bnparks-KSU/L3CertificationRocket/Documentation/Photos/Physical/AllParts-Airframe.jpg

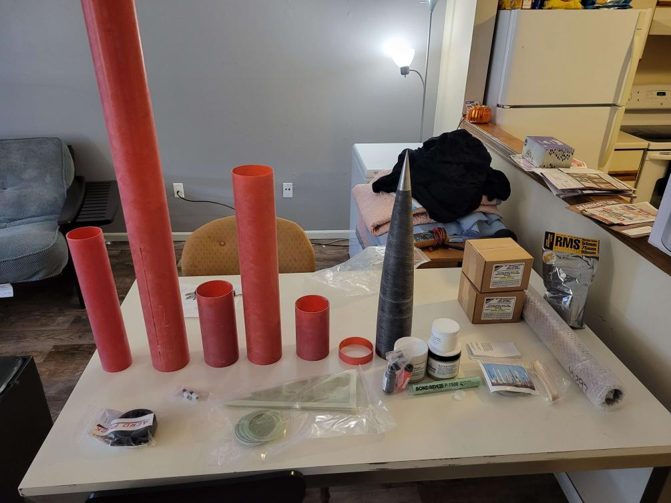
Documentation/Photos/Physical/AllParts-Airframe.jpg
