bnparks-KSU/L3CertificationRocket/Documentation/Photos/Physical/EBayAssembled.jpg

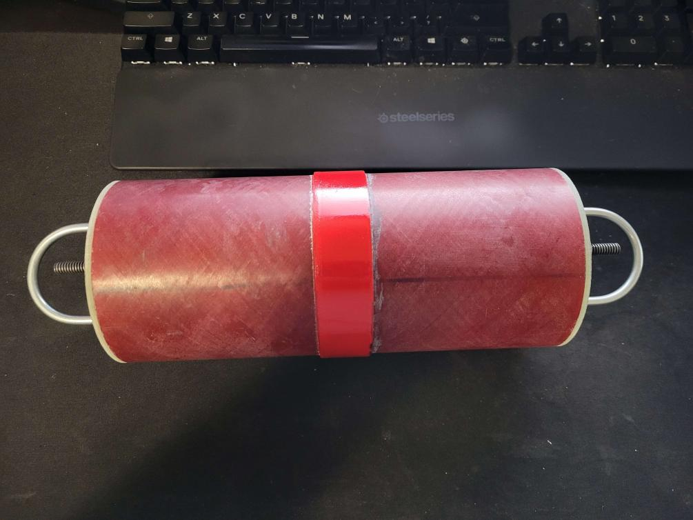
Documentation/Photos/Physical/EBayAssembled.jpg
