bnparks-KSU/L3CertificationRocket/Documentation/Photos/Physical/Bath.jpg

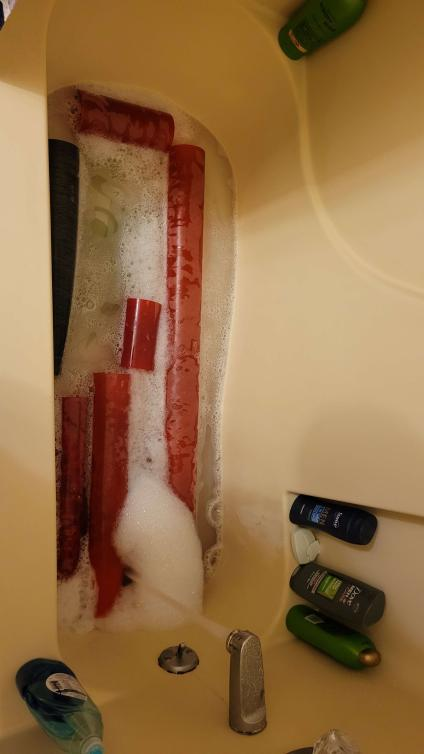
Documentation/Photos/Physical/Bath.jpg
