bnparks-KSU/L3CertificationRocket/Documentation/Photos/Physical/Box.jpg

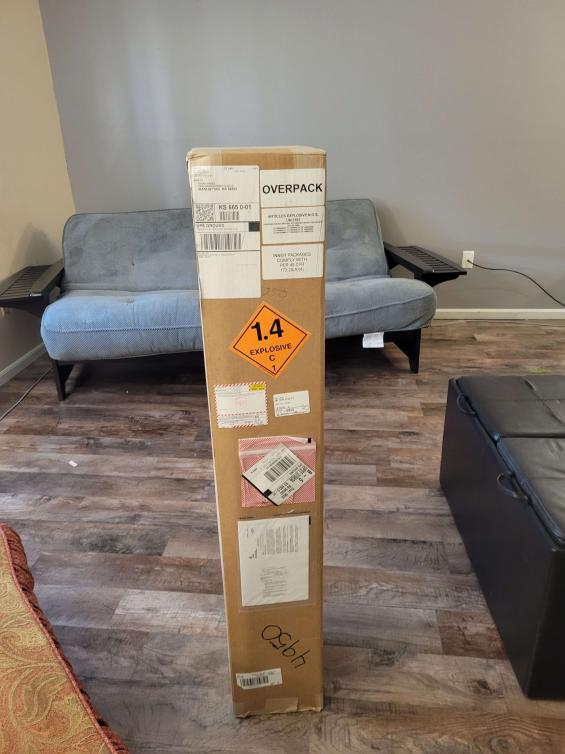
Documentation/Photos/Physical/Box.jpg
