bnparks-KSU/L3CertificationRocket/Documentation/Photos/Physical/BulkheadCNC.jpg

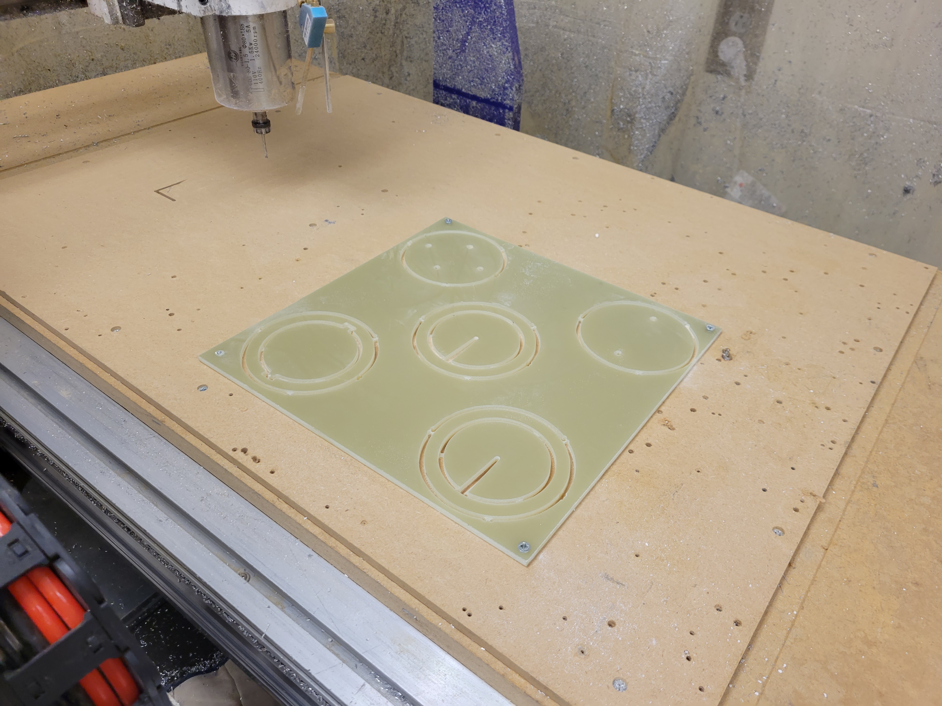
Documentation/Photos/Physical/BulkheadCNC.jpg
