bnparks-KSU/L3CertificationRocket/Documentation/Photos/Physical/ClampedBody.jpg

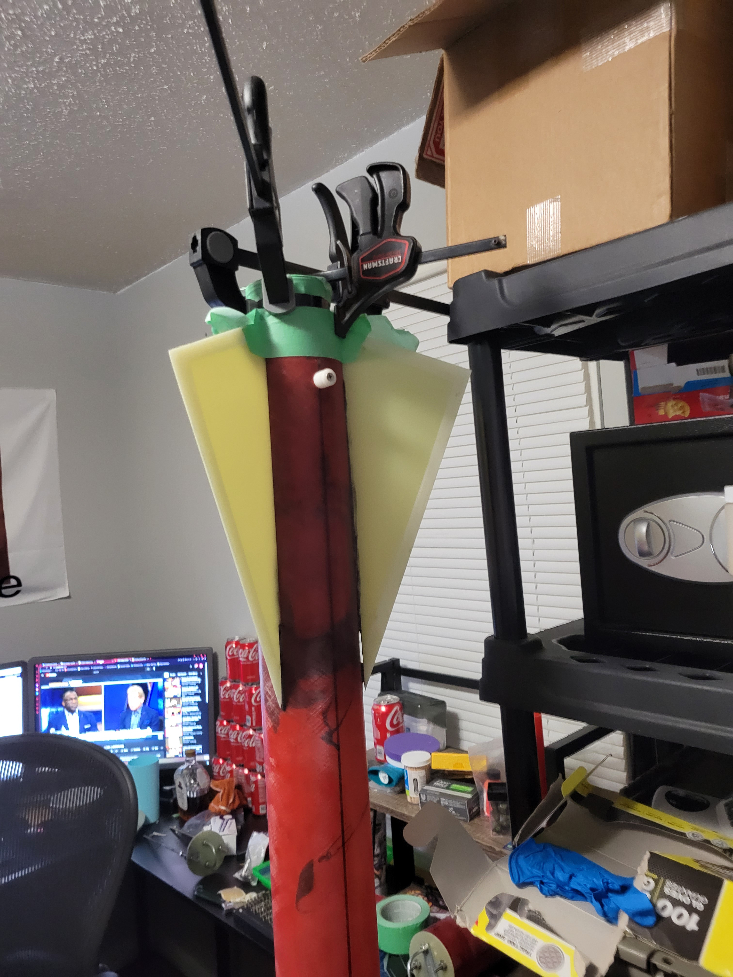
Documentation/Photos/Physical/ClampedBody.jpg
