bnparks-KSU/L3CertificationRocket/Documentation/Photos/Physical/DrogueRecovLayout.jpg

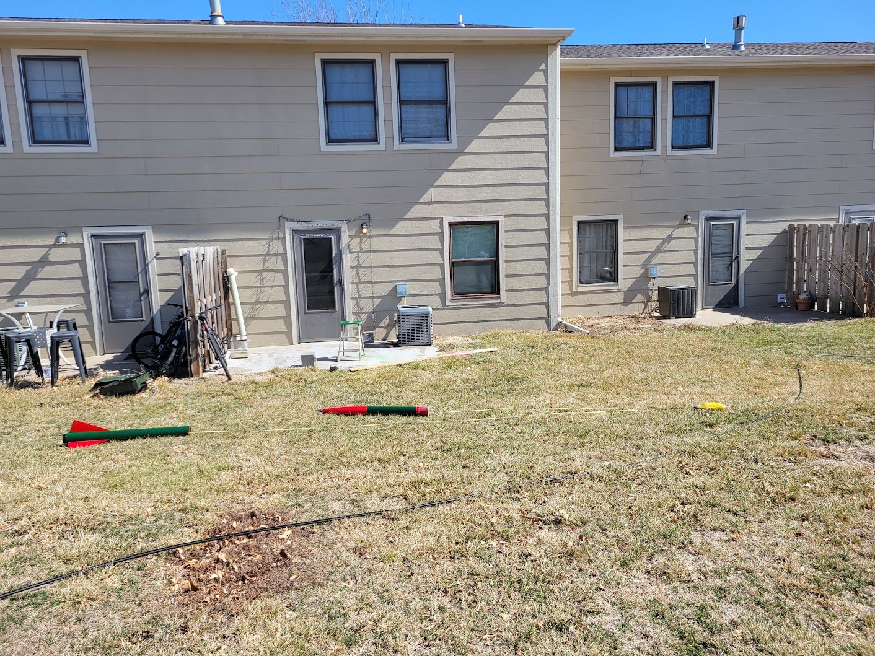
Documentation/Photos/Physical/DrogueRecovLayout.jpg
