bnparks-KSU/L3CertificationRocket/Documentation/Photos/Physical/DryFit-NoFin.jpg

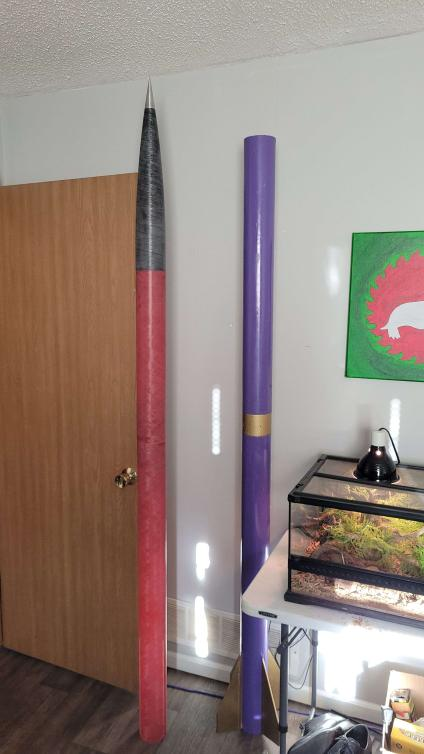
Documentation/Photos/Physical/DryFit-NoFin.jpg
