bnparks-KSU/L3CertificationRocket/Documentation/Photos/Physical/EBayBack.jpg

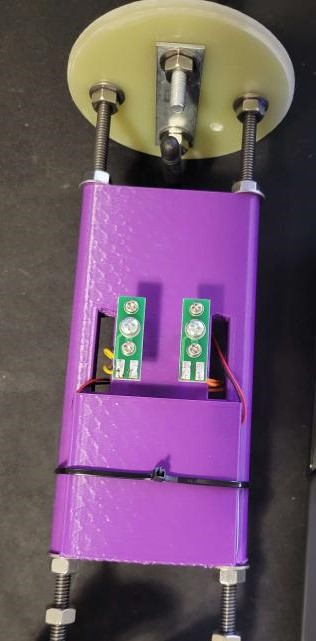
Documentation/Photos/Physical/EBayBack.jpg
