bnparks-KSU/L3CertificationRocket/Documentation/Photos/Physical/EBayFront.jpg

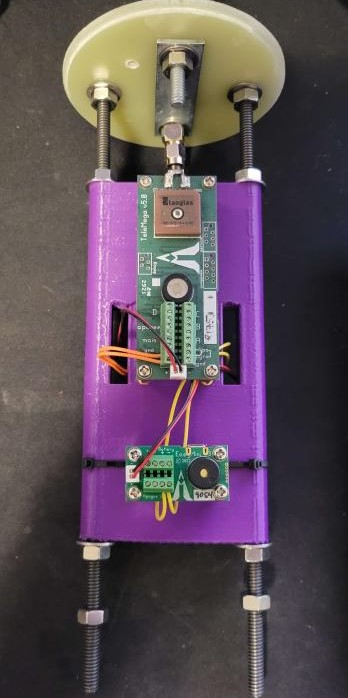
Documentation/Photos/Physical/EBayFront.jpg
