bnparks-KSU/L3CertificationRocket/Documentation/Photos/Physical/ExternalRocketpoxy.jpg

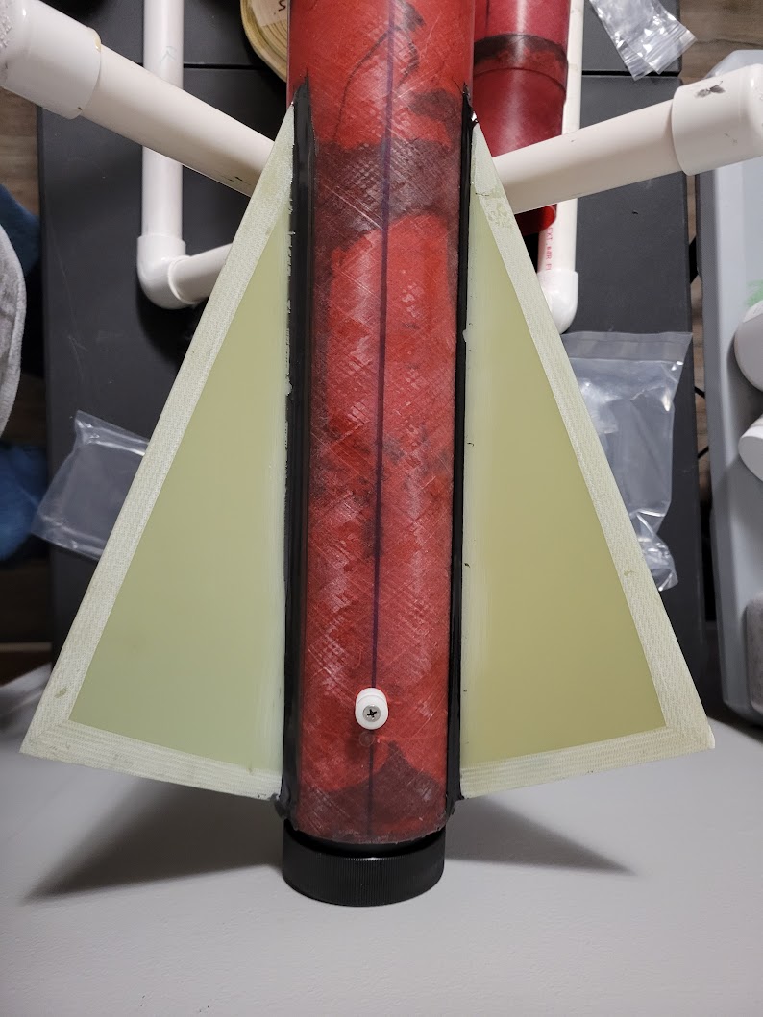
Documentation/Photos/Physical/ExternalRocketpoxy.jpg
