bnparks-KSU/L3CertificationRocket/Documentation/Photos/Physical/FinCan-Rocketpoxying.jpg

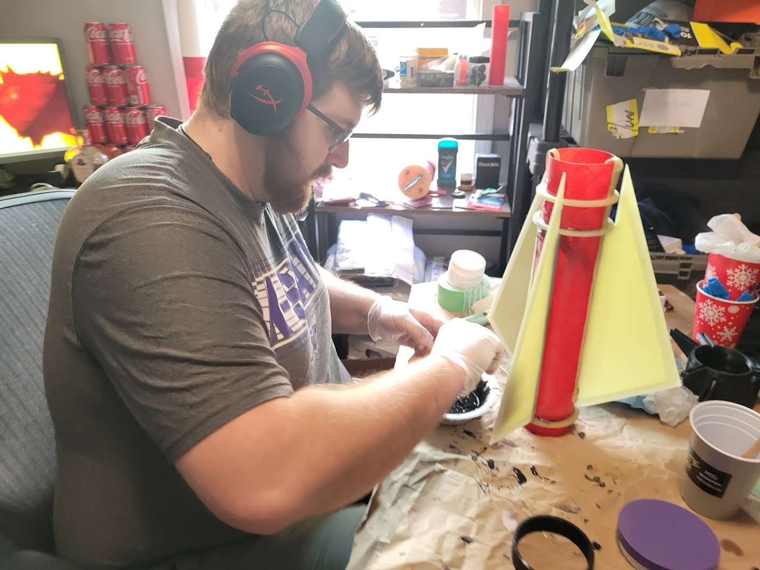
Documentation/Photos/Physical/FinCan-Rocketpoxying.jpg
