bnparks-KSU/L3CertificationRocket/Documentation/Photos/Physical/FinCanFinal.jpg

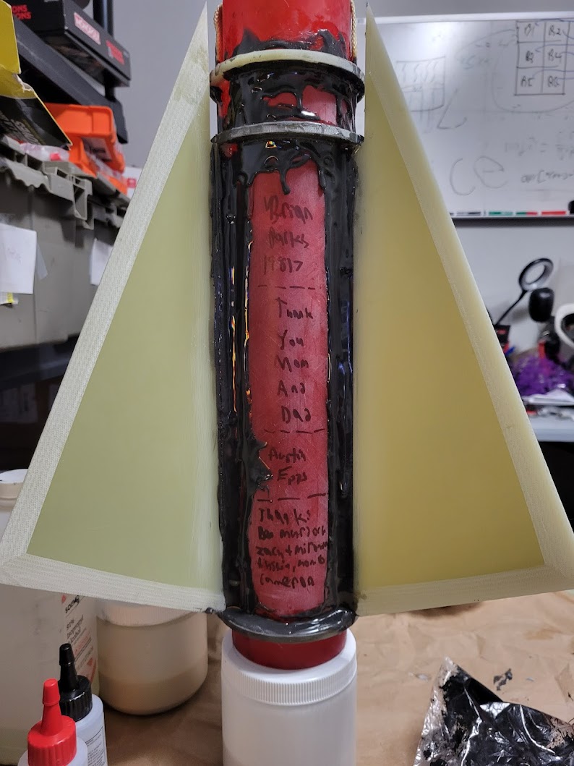
Documentation/Photos/Physical/FinCanFinal.jpg
