bnparks-KSU/L3CertificationRocket/Documentation/Photos/Physical/FinFilletPainting.jpg

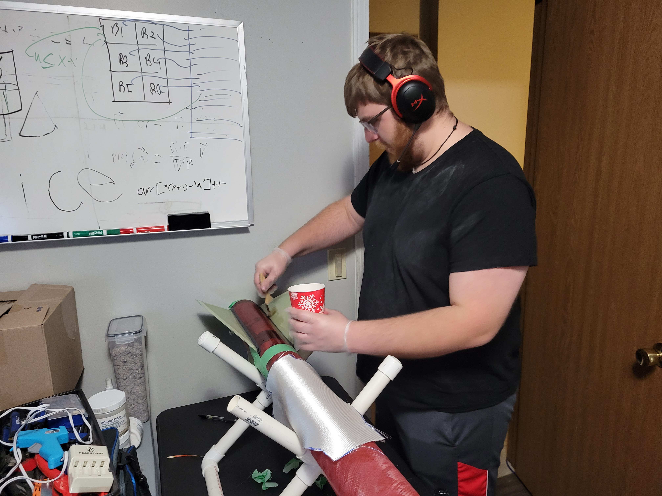
Documentation/Photos/Physical/FinFilletPainting.jpg
