bnparks-KSU/L3CertificationRocket/Documentation/Photos/Physical/FinFilletPeel.jpg

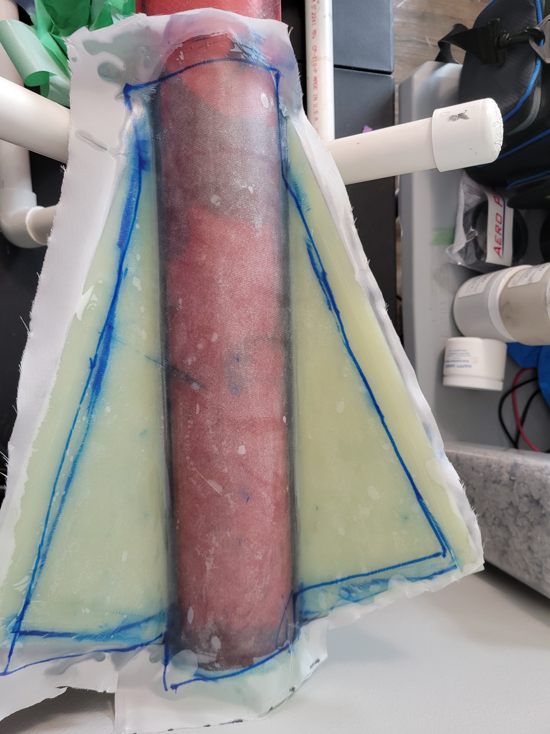
Documentation/Photos/Physical/FinFilletPeel.jpg
