bnparks-KSU/L3CertificationRocket/Documentation/Photos/Physical/FinSlotFilled.jpg

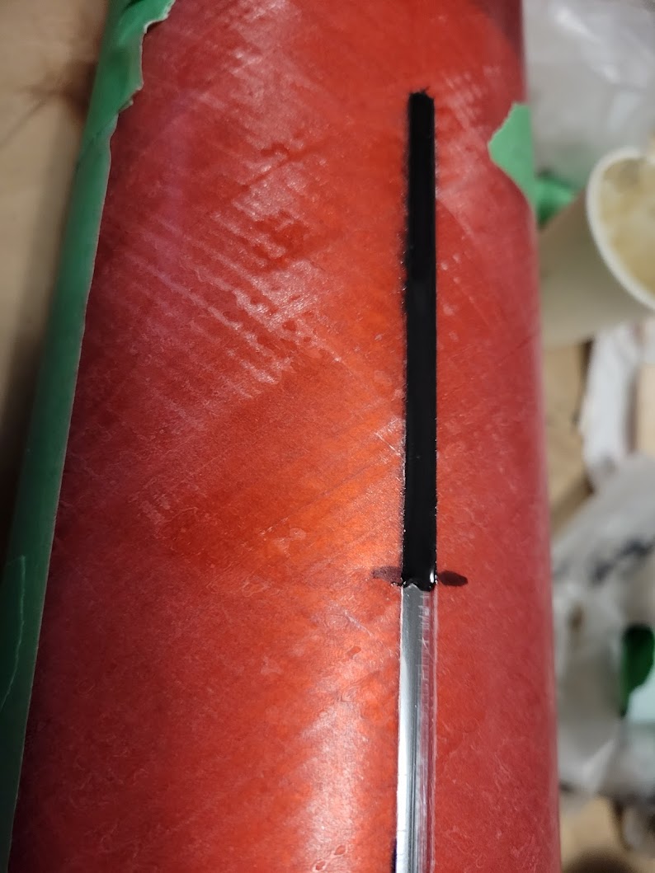
Documentation/Photos/Physical/FinSlotFilled.jpg
