bnparks-KSU/L3CertificationRocket/Documentation/Photos/Physical/FinSlotFilling.jpg

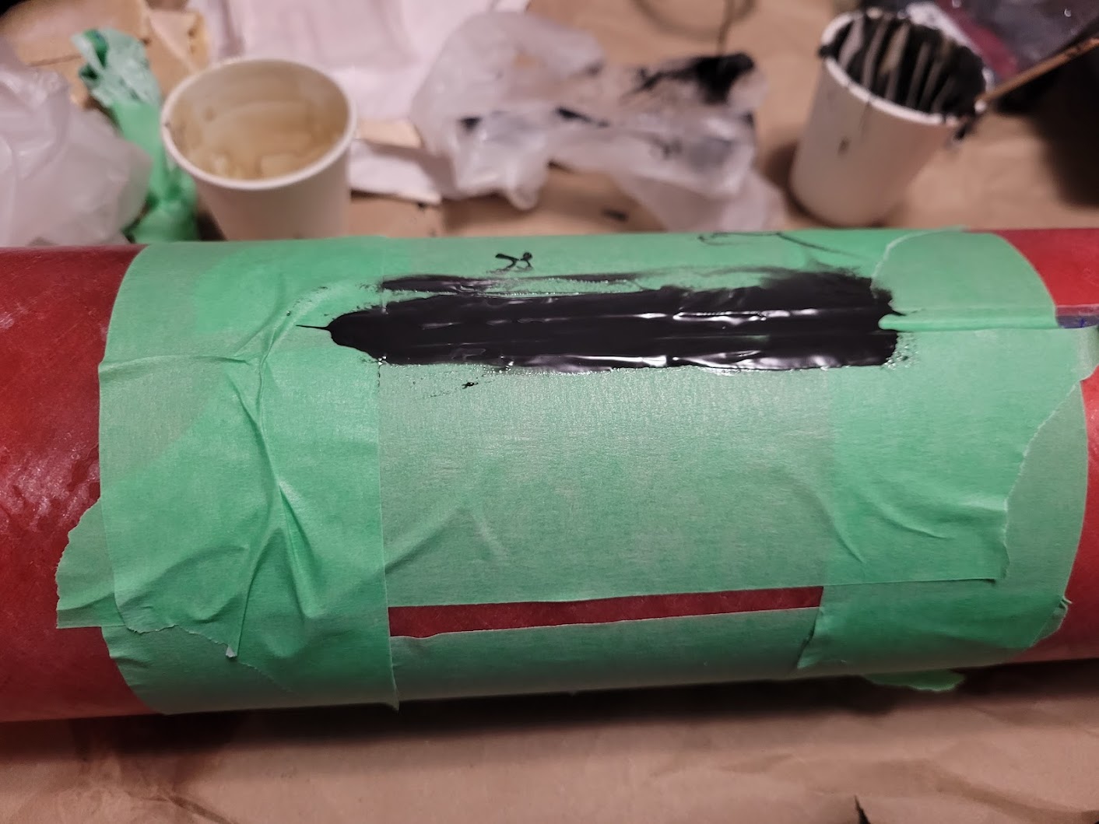
Documentation/Photos/Physical/FinSlotFilling.jpg
