bnparks-KSU/L3CertificationRocket/Documentation/Photos/Physical/FinSlotsTooBig.jpg

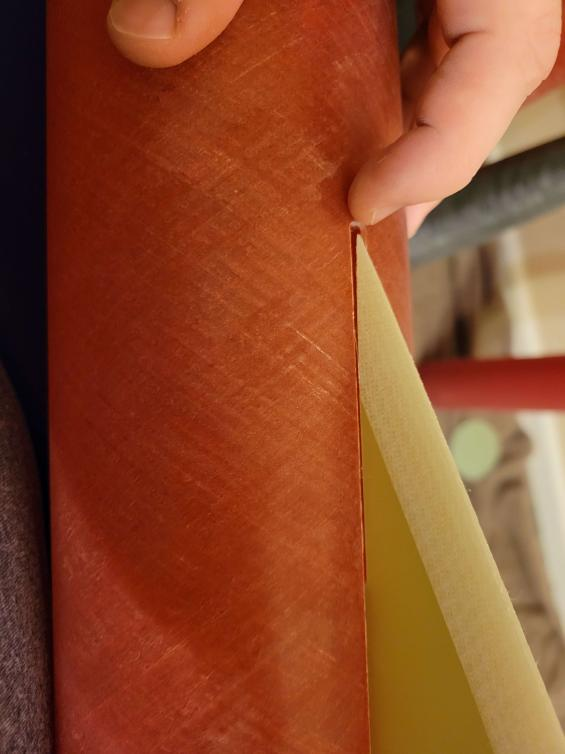
Documentation/Photos/Physical/FinSlotsTooBig.jpg
