bnparks-KSU/L3CertificationRocket/Documentation/Photos/Physical/FullRecovLayout.jpg

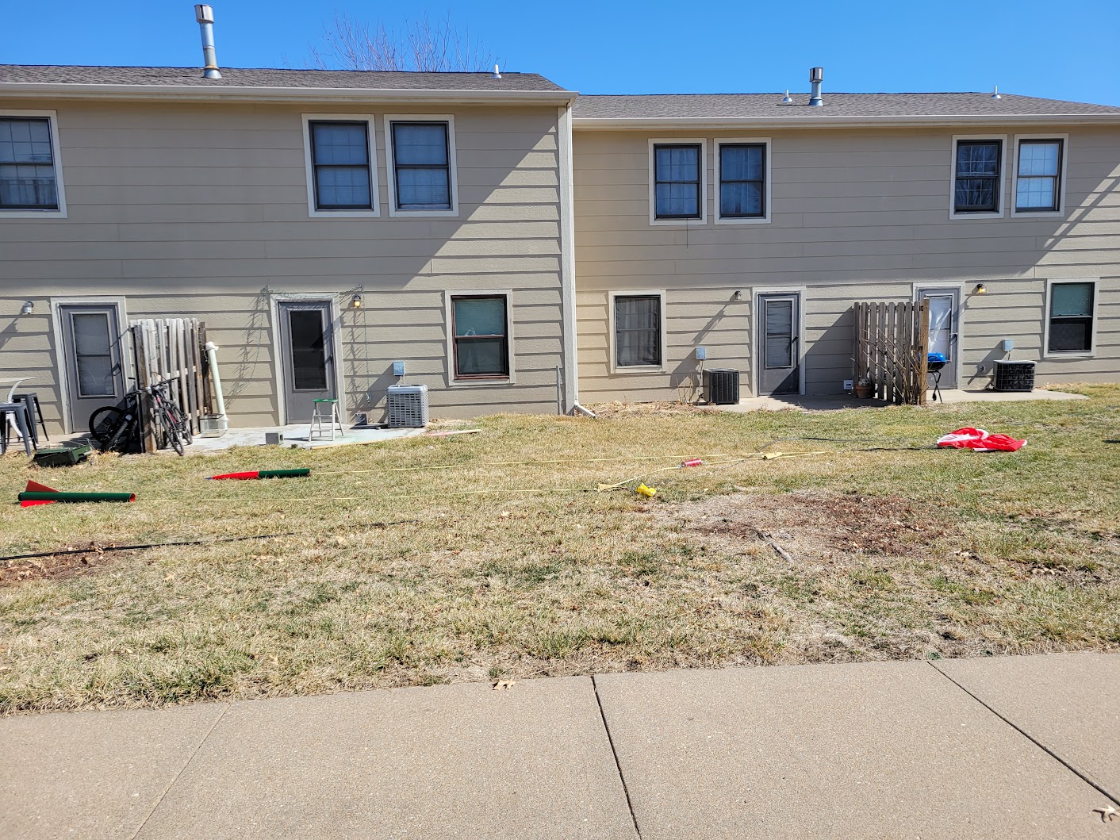
Documentation/Photos/Physical/FullRecovLayout.jpg
