bnparks-KSU/L3CertificationRocket/Documentation/Photos/Physical/LBT-Painted.jpg

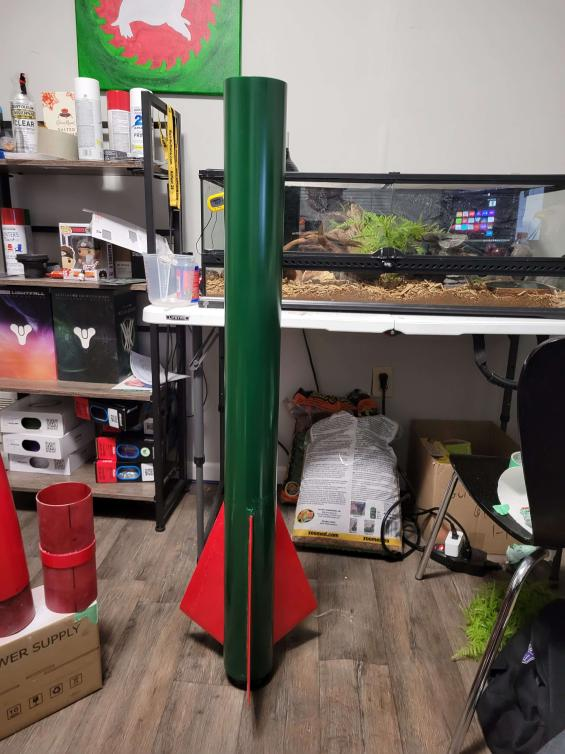
Documentation/Photos/Physical/LBT-Painted.jpg
