bnparks-KSU/L3CertificationRocket/Documentation/Photos/Physical/NC-SB-Painted.jpg

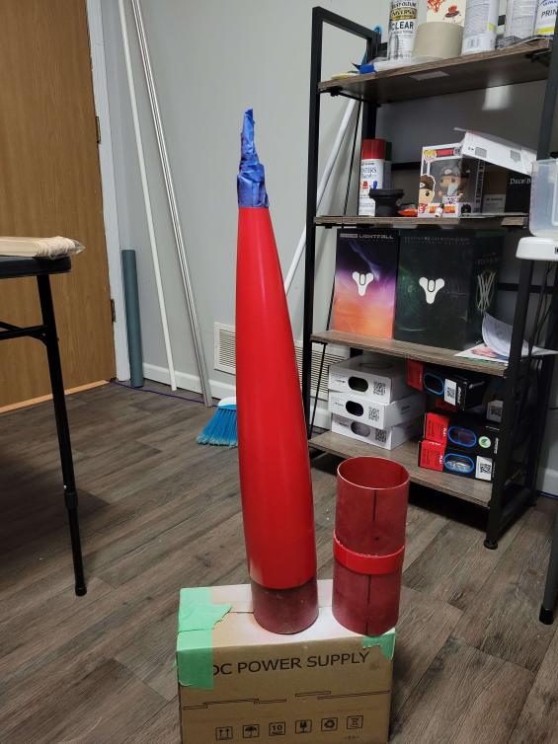
Documentation/Photos/Physical/NC-SB-Painted.jpg
