bnparks-KSU/L3CertificationRocket/Documentation/Photos/Physical/NoseconeCoupler-DryFit-Aft.jpg

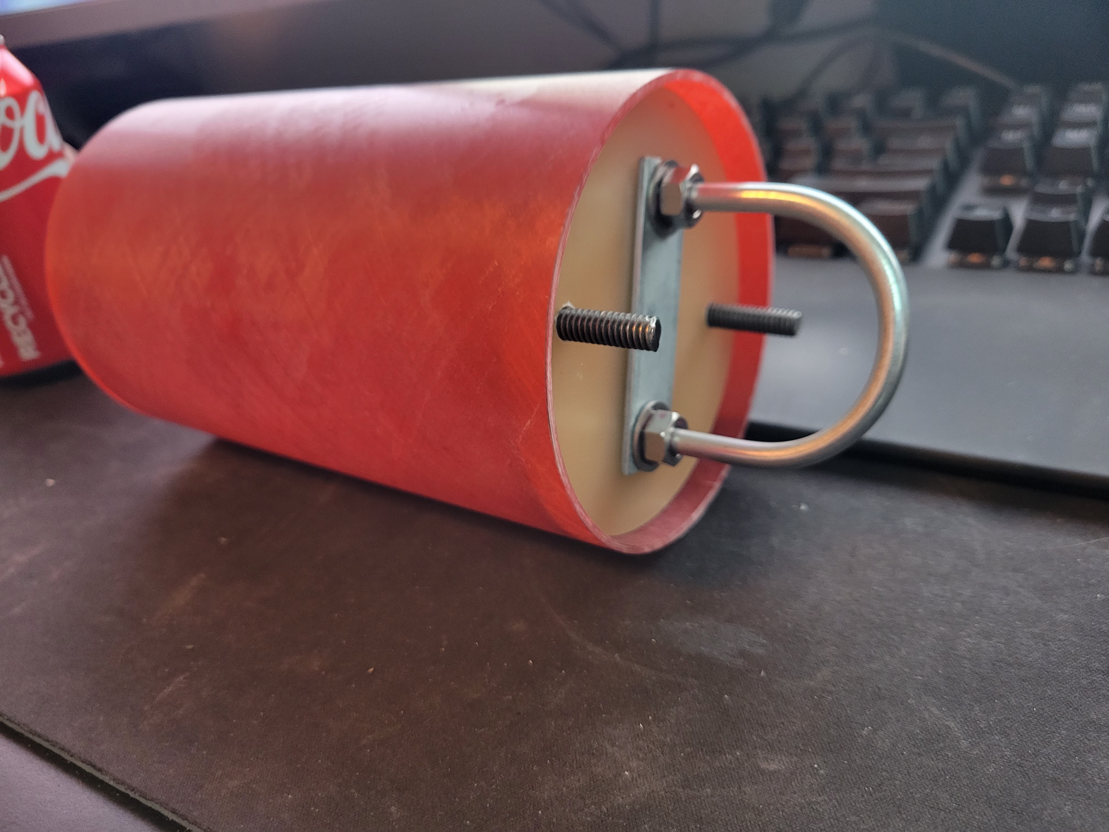
Documentation/Photos/Physical/NoseconeCoupler-DryFit-Aft.jpg
