bnparks-KSU/L3CertificationRocket/Documentation/Photos/Physical/NoseconeCoupler-DryFit-Forward.jpg

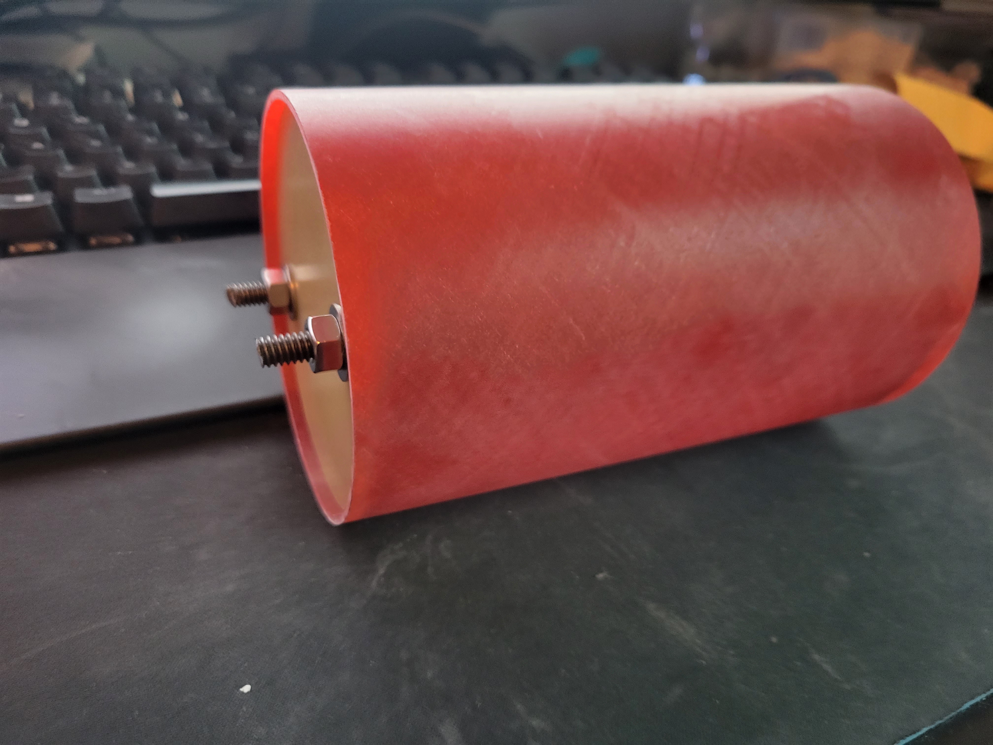
Documentation/Photos/Physical/NoseconeCoupler-DryFit-Forward.jpg
