bnparks-KSU/L3CertificationRocket/Documentation/Photos/Physical/NoseconeCoupler-Epoxy1.jpg

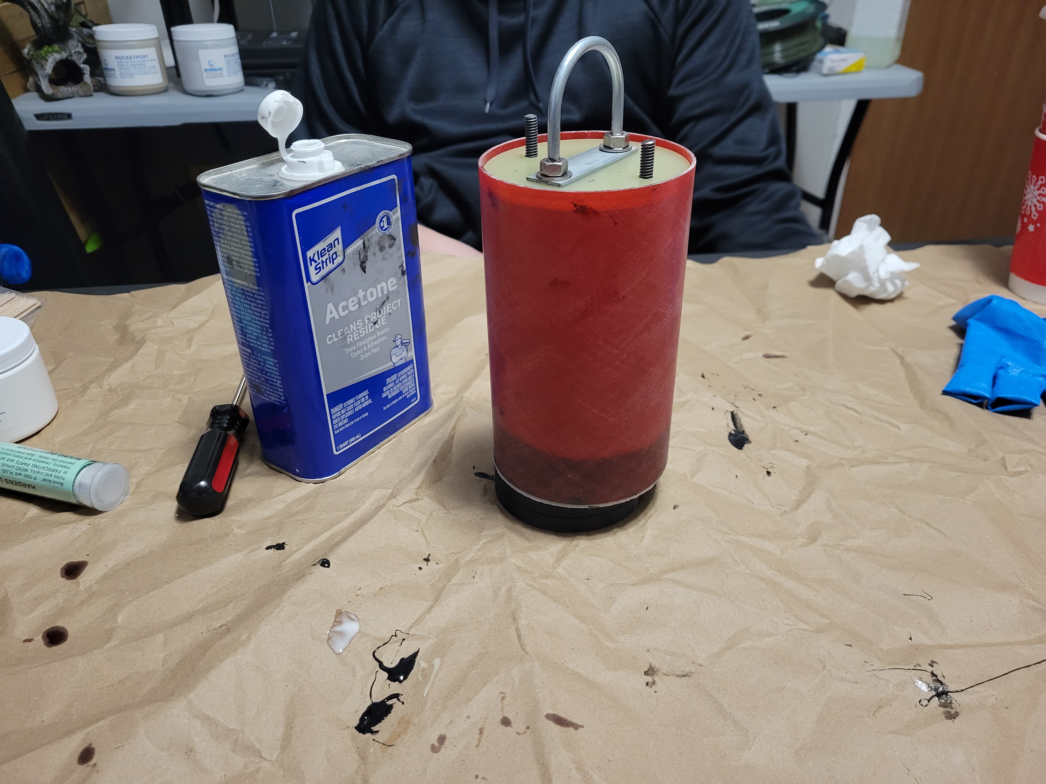
Documentation/Photos/Physical/NoseconeCoupler-Epoxy1.jpg
