bnparks-KSU/L3CertificationRocket/Documentation/Photos/Physical/NoseconeCoupler-Inserted.jpg

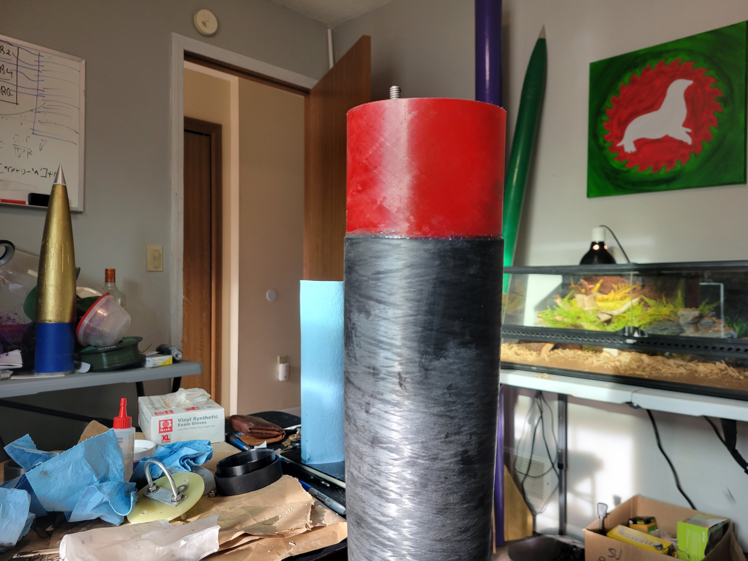
Documentation/Photos/Physical/NoseconeCoupler-Inserted.jpg
