bnparks-KSU/L3CertificationRocket/Documentation/Photos/Physical/PrimerCoats.jpg

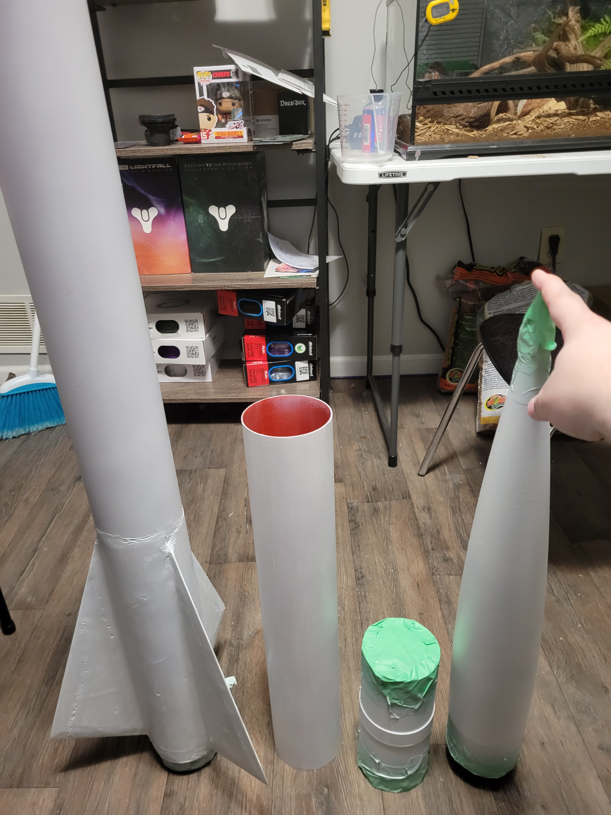
Documentation/Photos/Physical/PrimerCoats.jpg
