bnparks-KSU/L3CertificationRocket/Documentation/Photos/Physical/Switchband-Mounted.jpg

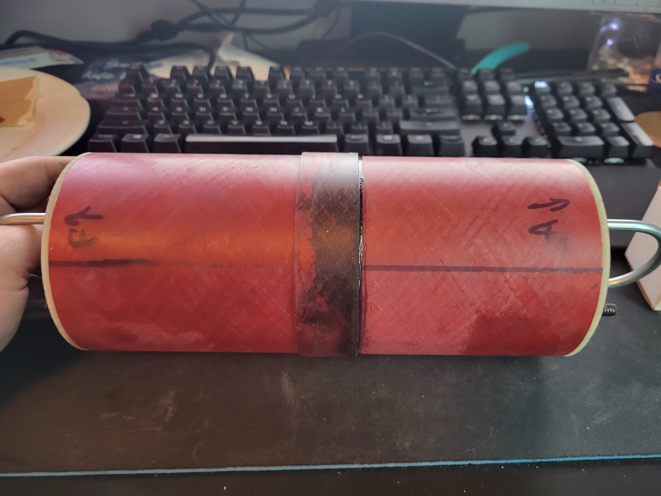
Documentation/Photos/Physical/Switchband-Mounted.jpg
