bnparks-KSU/L3CertificationRocket/Documentation/Photos/Physical/UBT-Painted.jpg

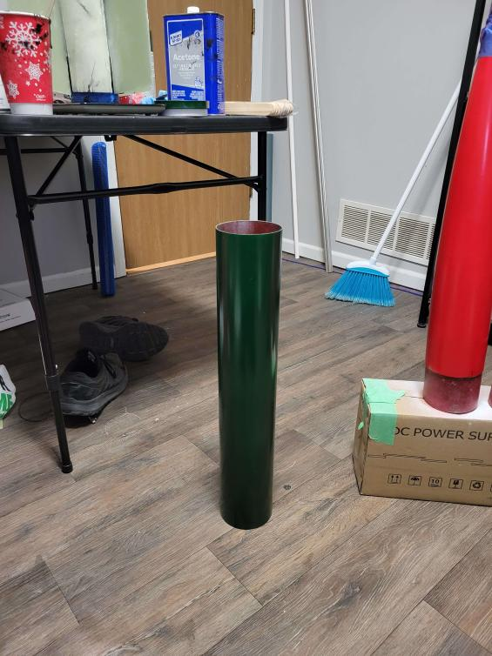
Documentation/Photos/Physical/UBT-Painted.jpg
