bnparks-KSU/L3CertificationRocket/Documentation/Photos/Solidworks/CenteringRingWithCutCAM.PNG

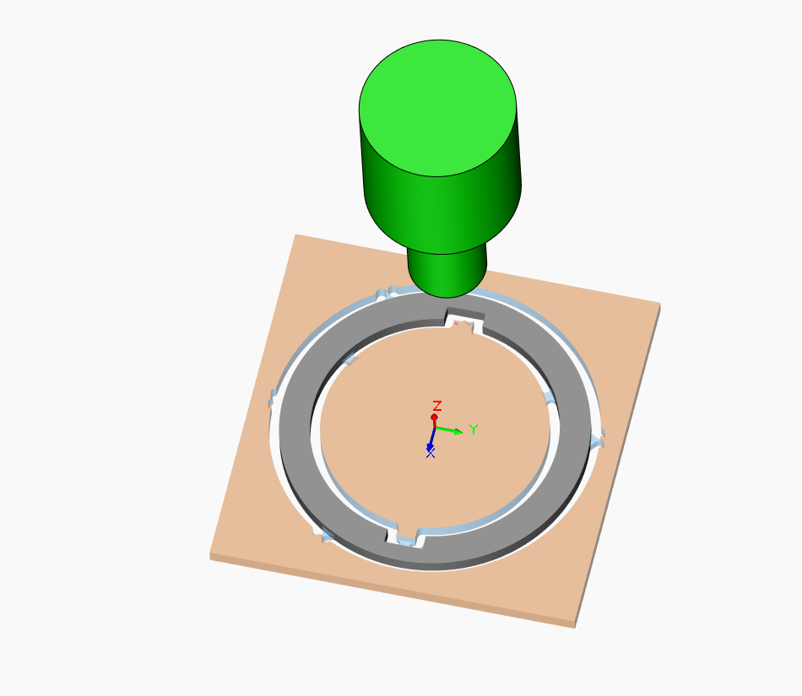
Documentation/Photos/Solidworks/CenteringRingWithCutCAM.PNG
