bnparks-KSU/L3CertificationRocket/Documentation/Photos/Solidworks/EBay.PNG

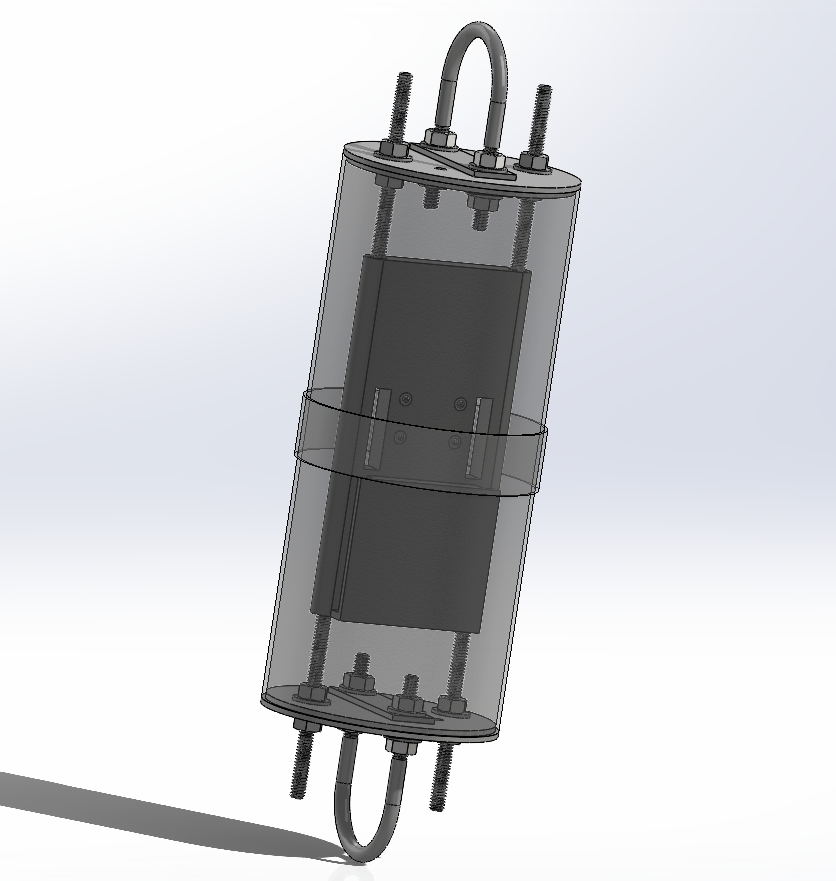
Documentation/Photos/Solidworks/EBay.PNG
