bnparks-KSU/L3CertificationRocket/Documentation/Photos/Solidworks/FinJig.PNG

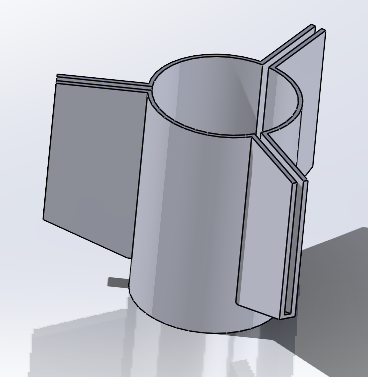
Documentation/Photos/Solidworks/FinJig.PNG
