bnparks-KSU/L3CertificationRocket/Documentation/Photos/Solidworks/L3-Model.PNG

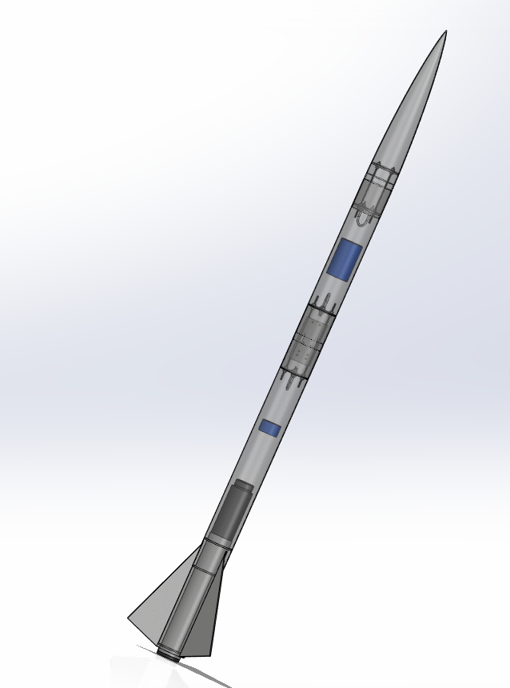
Documentation/Photos/Solidworks/L3-Model.PNG
