bnparks-KSU/L3CertificationRocket/Documentation/Photos/Solidworks/LaunchProfile.PNG

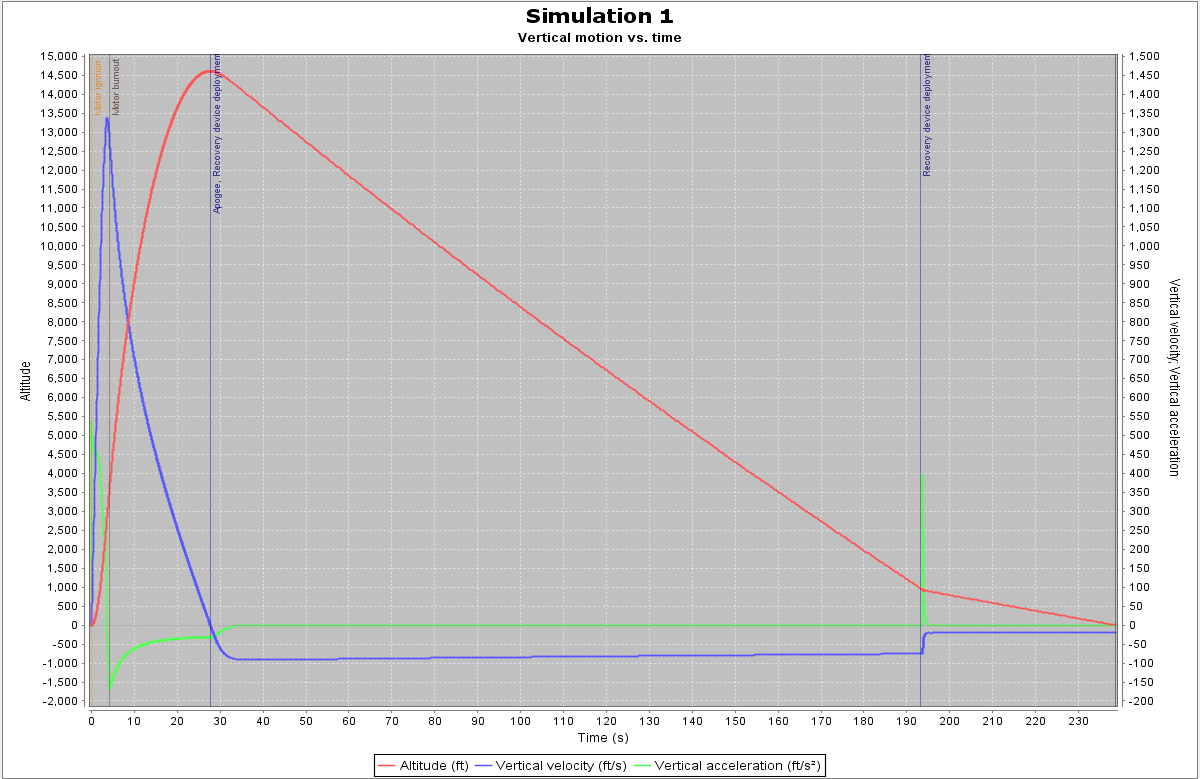
Documentation/Photos/Solidworks/LaunchProfile.PNG
