bnparks-KSU/L3CertificationRocket/Documentation/Photos/Solidworks/Nosecone.PNG

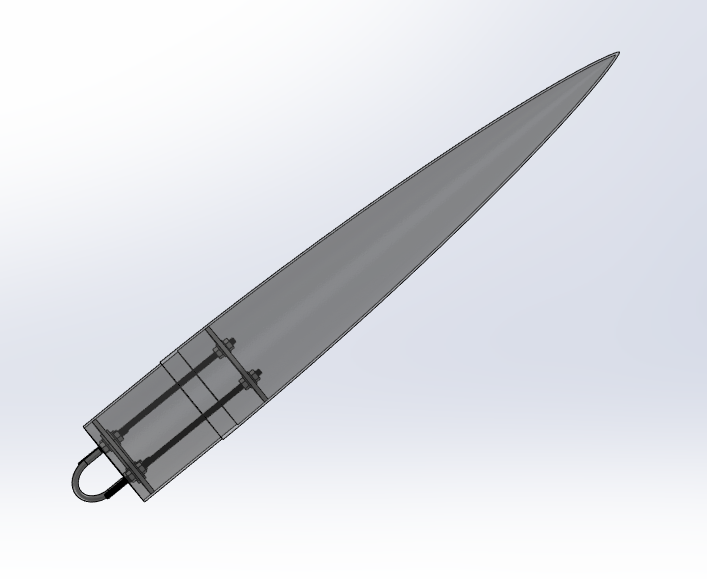
Documentation/Photos/Solidworks/Nosecone.PNG
