bnparks-KSU/L3CertificationRocket/Documentation/Photos/Solidworks/OpenRocket.PNG

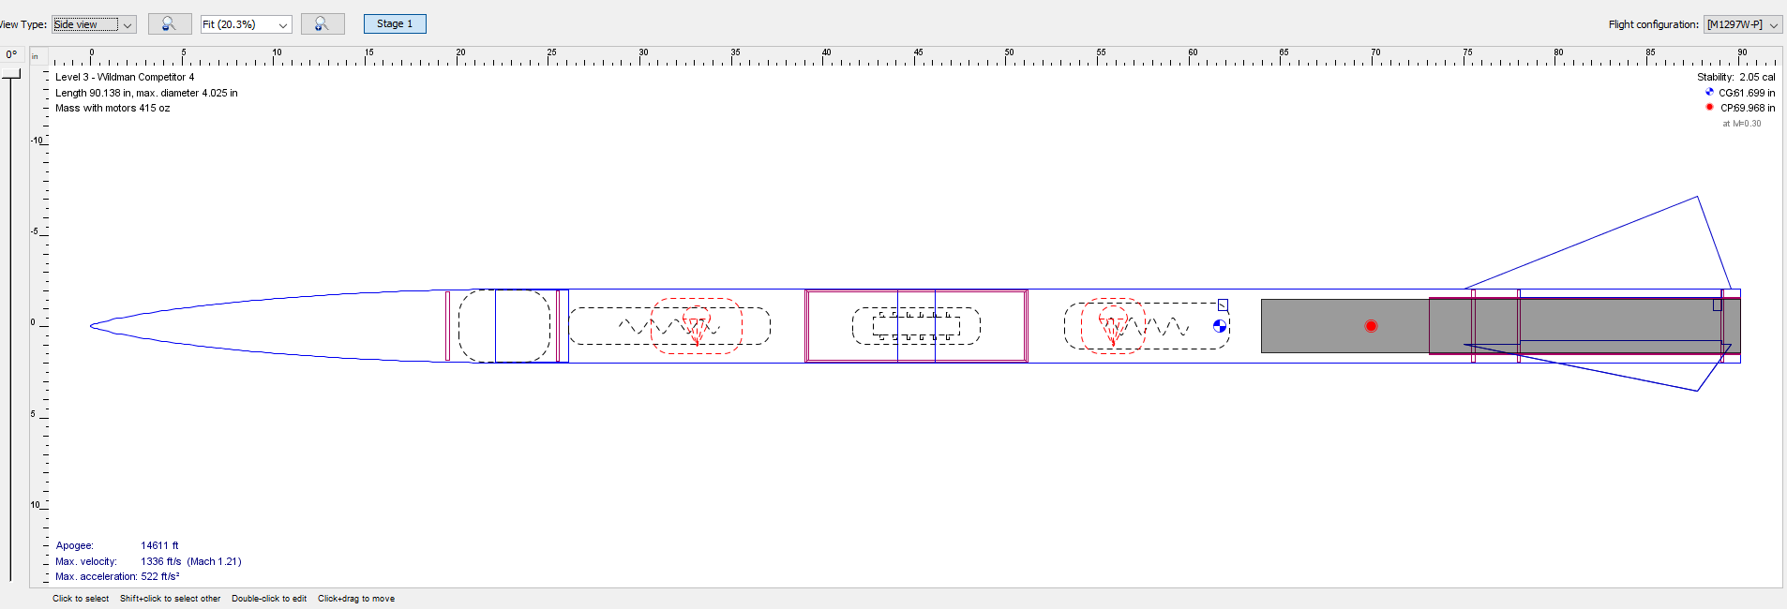
Documentation/Photos/Solidworks/OpenRocket.PNG
