bnparks-KSU/L3CertificationRocket/Documentation/Photos/Solidworks/PreFlightDataCapture.PNG

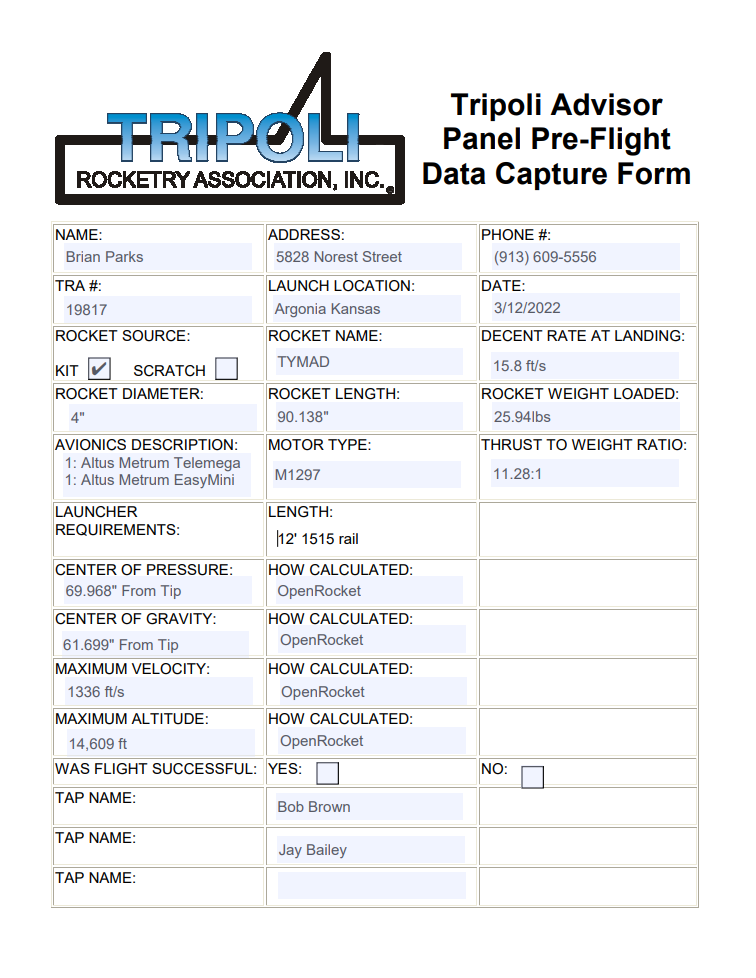
Documentation/Photos/Solidworks/PreFlightDataCapture.PNG
