bnparks-KSU/L3CertificationRocket/Documentation/Photos/Solidworks/Shoulder.PNG

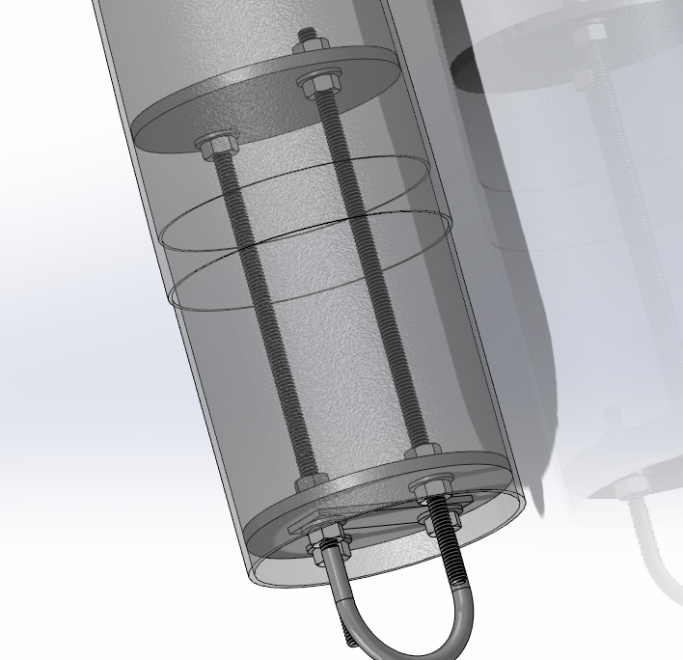
Documentation/Photos/Solidworks/Shoulder.PNG
