bnparks-KSU/L3CertificationRocket/Documentation/L3BOM.xlsx

Sheet: Summary
Category | Cost Total | Cost Remaining
Airframe | $400.97 | $0.00
Electronics | $507.00 | $0.00
Recovery | $228.05 | $134.05
Incidentals | $312.93 | $0.00
Total | $1448.95 | $134.05

Sheet: Airframe Materials
Item | Amount / Each | QTY | Total Cost | Purchased | Current Spent | Link:
Kit | $287.06 | 1.00 | $287.06 | 1 | $287.06 | https://wildmanrocketry.com/products/competitor-4 | Summary
Rail Guides | $9.00 | 1 | $9.00 | 1 | $9.00 | https://wildmanrocketry.com/products/2052-lg-rail-guides | Total Cost: | $400.97
Motor Retainer | $40.80 | 1 | $40.80 | 1 | $40.80 | https://wildmanrocketry.com/products/ra75p | Funding Needed: | $0.00
Rocketpoxy | $35.40 | 1 | $35.40 | 1 | $35.40 | https://wildmanrocketry.com/products/rocketpoxy-2-pint-kit
Extra G10 | $28.71 | 1 | $28.71 | 1 | $28.71 | https://wildmanrocketry.com/products/g10-3-16?_pos=1&_sid=27c007fa2&_ss=r
 |  |  | $0.00 | 1 | $0.00
 |  |  | $0.00 | 1 | $0.00
 |  |  | $0.00 | 1 | $0.00
 |  |  | $0.00 | 1 | $0.00
 |  |  | $0.00 | 1 | $0.00

Sheet: Electronics
Item | Amount / Each | QTY | Total Cost | Purchased | Current Spent | Link:
Telemega | $400.00 | 1 | $400.00 | 1 | $400.00 | https://csrocketry.com/electronics/altus-metrum/telemega.html | Summary
EasyMini | $80.00 | 1 | $80.00 | 1 | $80.00 | https://csrocketry.com/electronics/altus-metrum/easy-mini.html | Total Cost: | $507.00
850 mAh battery | $10.00 | 2 | $20.00 | 1 | $20.00 | https://csrocketry.com/electronics/altus-metrum/850-mah-battery.html | Funding Needed: | $0.00
Screw Switch | $3.50 | 2 | $7.00 | 1 | $7.00 | https://csrocketry.com/electronics/missleworks/6-32-screw-switch.html

Sheet: Recovery Hardware
Item | Amount / Each | QTY | Total Cost | Purchased | Current Spent | Link:
2ft Drogue | $33.50 | 1 | $33.50 | 1 | $33.50 | https://the-rocketman.com/chutes-html/ | Summary
6ft Main | $60.50 | 1 | $60.50 | 1 | $60.50 | https://the-rocketman.com/chutes-html/ | Total Cost: | $228.05
12" Flame Shield | $20.50 | 2 | $41.00 |  | $0.00 | https://the-rocketman.com/flame-shields/ | Funding Needed: | $134.05
Quick Links | $3.00 | 6 | $18.00 |  | $0.00 | Menards
Harness Set | $75.05 | 1 | $75.05 |  | $0.00 | https://wildmanrocketry.com/products/4-inch-harness?_pos=1&_sid=ddc1272e9&_ss=r

Sheet: Incidentals
Item | Amount / Each | QTY | Total Cost | Purchased | Current Spent | Link:
Casing | $0.00 | 1 | $0.00 |  | $0.00 | Borrowed from Team | Summary
M1297 | $256.35 | 1 | $256.35 | 1 | $256.35 | https://wildmanrocketry.com/products/m1297w | Total Cost: | $312.93
Threaded Rod (98957A801) | $3.06 | 2 | $6.12 | 1 | $6.12 | McMaster | Funding Needed: | $0.00
Ubolt (3043T618) | $5.28 | 1 | $5.28 | 1 | $5.28 | McMaster
Ubolt Plate (8875T929) | $1.91 | 2 | $3.82 | 1 | $3.82 | McMaster
Washers (92141A029) | $5.50 | 1 | $5.50 | 1 | $5.50 | McMaster
Nuts (91845A029) | $6.09 | 1 | $6.09 | 1 | $6.09 | McMaster
Heat Inserts (94180A331) | $16.81 | 1 | $16.81 | 1 | $16.81 | McMaster
Standoff Kit | $12.96 | 1 | $12.96 | 1 | $12.96 | https://www.amazon.com/Csdtylh-Male-Female-Standoff-Stainless-Assortment/dp/B06Y5TJXY1
