bnparks-KSU/L3CertificationRocket/Documentation/L3DCC.xlsx

Sheet: Data Input
Compiled Rocket Design Safety Checks Assembled by Ben Murdock, Brian Parks |  |  |  |  |  |  |  |  | Measurement System
 |  |  |  |  |  |  |  |  | Imperial
Launch Site Parameters |  |  | Vehicle Parameters |  |  | Flight Parameters
Parameter | Value | Unit | Parameter | Value | Unit | Parameter | Value | Unit
Ground Level Altitude | 1249 | ft | Outer Diameter | 4.025 | in | Motor Avg Thrust | 1297 | N
Highest Launch Temperature | 96 | °F | Wall Thickness | 0.062 | in | Velocity Off Rod | 112 | fps
 |  |  | Lonest Single Body Segment | 44.00 | in | Max Velocity | 1336 | ft/s
The password to the sheet is FFAero |  |  | Empty Rocket Mass | 15.75 | lb | Max Acceleration | 535 | f/s²
 |  |  | Fully Loaded Rocket Mass | 25.94 | lb | Peak Drag Coefficient | 0.55 |  | See cell comments to determine
Instructions: In order to use this spreadsheet successfully, first select the units highlighted in Blue, starting with the Measurement System, then editing the single units highlighted in Blue. DO NOT edit any of the units in red, some are automatically changed with the unit system, while others are not set up to accept other systems. This is currently due to my own lack of will to correct for this, but you may expect it in the future. After the units have all been set, input the respective values into the green highlighted cells. Some, such as the Body Material, have drop down boxes for different materials. Use the one closest to the actual rocket. For the Fin measurements, refer to the picture to the right. After all data is entered, refer to the Data Summarization Sheet for a compiled list of all data outputs. |  |  | Body Material | Fiberglass - G-10
 |  |  | Safety Margin for all Calculations | 1.20
 |  |  | Altimeter Bay
 |  |  | Altimeter Bay Radius | 2 | in
 |  |  | Altimeter Bay Length | 9 | in
 |  |  | Number of Static Ports | 4
 |  |  | Fins
 |  |  | Root Chord (Cr) | 14.6 | in
 |  |  | Tip Chord (Ct) | 0 | in
 |  |  | Semi Span (height) (b) | 5.1 | in
 |  |  | Thickness (th) | 0.1875 | in
 |  |  | Shear Modulus (G) | 892857 | psi | (Shear Modulus of E-Glass)
 |  |  | Altitude at Burnout (h) | 3750 | ft | Determined by OpenRocket Sim
 |  |  | Parachute Bays
 |  |  | Main Bay Length | 30 | in
 |  |  | Drogue Bay Length | 22 | in
 |  |  | Main Bay Force | 200 | lbs
Kloudbusters Rocket Pasture in March |  |  | Drogue Bay Force | 100 | lbs
Ground Level Altitude | 1249 | ft
 | 380 | m
Highest Launch Temperature | 96 | °F
 | 35.5 | °C
Spaceport America in June
Ground Level Altitude | 4595 | ft
 | 1511.5 | m
Highest Launch Temperature | 96 | °F
 | 35.5 | °C

Sheet: Data Summarization
Raw Data Output |  |  | Data Analyzed
Axial Loading Limit | 12350.53063 | lbf | Thrust-to-Weight | Ratio is acceptable, >4:1
Euler's Buckling Limit | 339.5853133 | lbf | Compression Force | Warning: Tube will buckle!
 |  |  | Fin Flutter Boundary | The Max Velocity is over the Safety Margin, but not yet crossing the boundary.
Safe Wind Speed Launch | 19.09 | mph
Thrust-to-Weight Ratio | 11.28
Total Compression Force | 362.84 | lbf
Number of Static Ports | 4
Static Port Size | 0.125 | in
Fin Flutter Boundary Velocity | 1390.97 | ft/s
 | 423.95 | m/s
 | 1.32 | Mach
Main Primary Charge | 3.10 | grams
Drogue Primary Charge | 1.14 | grams

Sheet: BP Calculations
Main Parachute |  | Drogue Parachute |  | Source:
Diameter (in) | 3.963 | Diameter (in) | 3.963 | http://hararocketry.org/hara/resources/how-to-size-ejection-charge/
Length (in) | 30 | Length (in) | 22
Bulkhead Force | 200 | Bulkhead Force | 100
Ejection Charge Calculations |  | Ejection Charge Calculations
Required Pressure (psig) | 16.21 | Required Pressure (psig) | 8.11
Charge Size (grams) | 3.10 | Charge Size (grams) | 1.14

Sheet: Rocket Safety Mark McCord
*green fields = key in data (pay attention to units!)
*blue fields = select from drop down list
*yellow fields = critical values to watch for safety
Rocket Dimensions |  |  |  |  | Flight Parameters
Parameter | Value | Units | Comments |  | Parameter | Value | Units | Comments
Outer Diameter | 4.025 | in |  | 4.025 | Motor Avg Thrust | 1297 | N |  | 1297
Wall Thickness | 0.062 | in |  | 0.062 | Velocity off Rod | 112 | fps |  | 34.1376
Longest Single Body Segment | 44.000 | in | note: not full rocket length | 44 | Max Velocity | 1336 | fps |  | 407.2128
Empty Rocket Mass | 15.750 | lb |  | 7.14 | Max Acceleration | 535 | f/s² |  | 163.0679948
Fully Loaded Rocket Mass | 25.940 | lb |  | 11.77 | Peak Drag Coefficient | 0.55 |  | see cell comments to determine
Body Material | Fiberglass - G-10
 |  |  |  |  | air pressure | 14.7 | psia
Inner Diameter | 3.901 | inches |  |  | air constant | 1.4
Cross-sectional Area | 0.77 | sq. inches |  |  | air density | 1.225 | kg/m³
Drag Reference Area | 12.72 | sq. inches |  |  | Max Gs | 16.6 | G
Modulus of Elasticity | 43946.514 | lb.in² |  |  | Mach | 1.19
Moment of Inertia | 1.52 | lb.in² |  |  | Drag Force | 101.4971277 | pounds force
 |  |  |  |  | Inertial Force | 261.3473968 | pounds force
Axial Load Limit | 12350.53063 | pounds force | point where tube will crush |  | Safe Wind Speed Launch | 19.1 | mph | Typically 4x speed off rail
Euler Buckling Limit | 339.5853133 | pounds force | point where tube will buckle |  | Thrust-to-Weight Ratio | 11.3 | thrust/loaded mass | Check OK: Minimum 4:1
 |  |  |  |  | Total Compression Force | 362.8445244 | pounds force | Warning: Tube will buckle!

Sheet: Static Ports
Static Port Hole Calculator by Gary Stroick
Constants
 | Imperial |  | Metric
Variables | Values | Units | Values | Units
Air Specific Heat Ratio | 1.401
Discharge Coefficient | 0.62
g | 32.17404856 | ft s-2 | 9.80665 | m s-2
Gas Constant | 89494.596 | lbm ft2 lb-mol-1 K-1 s-2 | 8.31432 | N m mol-1 K-1
Lapse Rate | -0.0019812 | °K ft-1 | -0.0065 | °K m-1
One Atmosphere | 29.92126 | inHg | 101325 | Pa
One Mole Air Density | 28.9645 | lbm lb-mol-1 | 0.0289645 | kg mol-1
Conversion Factors
 | Values | Units
inHgtoPSF | 70.7261873 | lbf ft-2
JouletoLAtm | 0.0098692 | J L-1 Atm-1
LitertoCubicInches | 61.023744 | in3
MeterstoInches | 39.37007874 | in
MeterstoFeet | 3.280839895 | ft
Enter Data Values into Turquoise Cells
Measurement System | Imperial
Anticipated Launch Parameters (Optional) | Values | Units
Highest Launch Temperature | 96 | °C | 9.5 | °C
Lowest Launch Altitude | 1249 | ft | 253 | m
Maximum Velocity | 1336 | ft/s | 122 | m/s
Avionics Bay Parameters (Required) | Values | Units | Values | Units
Altimeter Bay Radius | 2 | in | 7.4 | cm
Altimeter Bay Length | 9 | in | 29.2 | cm
Number of Ports | 4 |  | 4
Atmospheric Pressure at Launch Altitude | 28.68198889 | inHg | 98264.64403 | Pa
Air Density (Dry Air) | 0.0684258186 | lbm/ft3 | 1.211121171 | kg/m3
Atmospheric Pressure Change | 0.01116% |  | 0.0001215692616
Pressure Equalization Rate | 0.002455718484 | s | 0.008196721311 | s
Choked Threshold | 1.893532653 |  | 1.893532653
Altimeter Bay Volume | 113.0973355 | in3 | 5023.38152 | cm3
Air Mass | 0.004478459355 | lbm | 0.006083923708 | kg
Mass Flow Rate | 0.0002034422786 | lbm/s | 9.023340976e-05 | kg/s
Size of Ports | 0.125 | in
COPYRIGHT © 2015 BY OFF WE GO ROCKETRY, LLC. ALL RIGHTS RESERVED. To anyone who acknowledges that this software is provided "AS IS" without any express or implied warranty: permission to use, copy, modify, and distribute this software for any purpose is hereby granted without fee, provided that the above copyright notice and this notice appears in all copies, and that the name of Off We Go Rocketry not be used in advertising or publicity pertaining to distribution of the software without specific, written prior permission. Off We Go Rocketry makes no representations about the suitability of this software for any purpose. OFF WE GO ROCKETRY IS NOT LIABLE FOR ANY DAMAGES, INCLUDING COMPENSATORY, SPECIAL, INCIDENTAL, EXEMPLARY, PUNITIVE, OR CONSEQUENTIAL DAMAGES, CONNECTED WITH OR RESULTING FROM THE USE OF THIS SOFTWARE.

Sheet: Fin Flutter
Fin Flutter Speed Calculator by Ben Murdock
Variables | Value | Units |  | To use this calculator, edit the values in the blue highlighted areas. The image to the right helps to identify each value for fin dimensions. The yellow values are derived from the input values. The values printed in green are the respective fin flutter boundary velocities for that configuration.
Safety Margin | 1.20 | (Unitless)
Root Chord (Cr) | 14.6 | in
Tip Chord (Ct) | 0 | in
Semi Span (height) (b) | 5.1 | in
Thickness (th) | 0.1875 | in
Shear Modulus (G) | 892857 | psi
Altitude at Burnout (h) | 3750 | ft | Pull from OpenRocket Simulation
Calculated Values
Temperature at Altitude (Tb) | 45.65 | °F
Surface Area (S) | 37.23 | in2
Aspect Ratio (AR) | 0.70 | (Unitless)
Taper Ratio (Gamma) | 0.00 | (Unitless)
Atmospheric Pressure | 1846.87 | lbs/ft2
Atmospheric Pressure Conv. (P) | 12.83 | lbs/in2
Speed of Sound (a) | 1052.79 | ft/s
Fin Flutter Boundary Velocity (Vf) | 1390.97 | ft/s
 | 423.95 | m/s
 | 1.32 | Mach
Fin Flutter Boundary Velocity with Safety Margin(Vf) | 1159.14 | ft/s
 | 353.29 | m/s
 | 1.10 | Mach

Sheet: Reference Data
Material Properties
 | Axial Peak Stress | Young's Modulus of Elasticity (Tensile Modulus)
Tube Material | Peak Stress (psi) | Modulus (MPa) | Comments
Ash | 11603 | 125
Balsa | 3625 | 41
Birch | 14503 | 114
Birch Plywood Reinforcement | 5500 | 100
Carbon Fiber | 16000 | 896 | fails from interlaminar shear, same as FG
Cardboard - Concrete Forms (Sonotube/Quikrete) | 1100 | 10
Cardboard - Concrete Forms - Fiberglassed | 2100 | 125
Cardboard - Concrete Forms - Polyurethane Fiberglassed | 1700 | 90
Cardboard - Glassine Coated | 2500 | 65
Cardboard - Heavy Shipping | 1700 | 65
Cardboard - Light Shipping | 1100 | 30
Cardboard - LOC | 1000 | 100
Cardboard - Heavy Shipping - Fiberglassed | 5100 | 250 | 2 x 6 oz. layers w/West System 106/206
Cardboard - Heavy Shipping - Polyurethane Fiberglassed | 3400 | 200 | 2 x 6 oz. layers w/Evercoat 105499
Cardboard - Light Whitewall | 2200 | 35
Elm | 10152 | 12
Fiberglass - G-10 | 16000 | 303 | fails from interlaminar shear
Maple | 3120 | 90
Oak | 8847 | 90
Phenolic (Bluetube) | 5400 | 125
Pine | 5366 | 78
Pine Plywood Reinforcement | 4300 | 57
Spruce | 5366 | 148
Willow | 4061 | 70

Sheet: Reference Formulae
Name | Formula | Units | Name | Formula | Units
Airframe Load | FDrag + FInertia | pounds force | Euler's Buckling Limit | n * π^2 * E * I/(L^2) | pounds force
 |  |  | n = factor accounting for end conditions | n=1 for two free ends like a flexing rocket | unitless
Name | Formula | Units | E = modulus of elastisity | from reference data | lb/in2
FDrag (supersosnic flight) | 0.5 * k * p * M^2 * Cd * A | pounds force | L = length of column (in) | from rocket body | in
A = Reference area as in2 | rocket body | in^2 | I = Moment of inertia (in4) |  | in4
C = Drag coefficient unitless | max Cd | unitless
M = Velocity in mach | max velocity | mach | Name | Formula | Units
p = pressure of air (assume sea level) in psia | 14.7 | psia | Moment of inertia | π^2 * ((Do^4) - (Di^4)))/ 64 | in4
k = air constant at sea level | 1.4 | unitless | Do = outer diameter (in) | from rocket body | in
 |  |  | Do = inner diameter (in) | from rocket body | in
Name | Formula | Units
FDrag (subsonic flight) | (0.5 * ρ * V^2 * Cd * A)/4.44 | pounds force
A = Reference area in m2 | from rocket body | m2
C = Drag coefficient unitless | max Cd | unitless
V = Velocity in m/s | max velocity | m/s
ρ = Density of fluid (liquid or gas) in kg/m3 | 1.225 | kg/m3
Name | Formula | Units
Finertia | m * a | pounds force
m = mass in lbs | from rocket | lbs
a = acceleration in Gs | from flight data | G

Sheet: Resources
Resources used by Mark McCord to design the Rocket Safety Sheet
Axial Compression Theory | http://www.nakka-rocketry.net/fusestru.html
Euler Buckling Theory | http://www.continuummechanics.org/columnbuckling.html
Axial Compression Data | http://web.archive.org/web/20070810025517/http://www.rocketmaterials.org/data/tubes/Axial/index.php
Modulus of Elasticity Data | http://upcommons.upc.edu/pfc/bitstre...ekulic_TFM.pdf
Fiber Data | http://www.diversified-composites.com/rdtbshp.php
Fiber/Epoxy Composite Data | http://www.scielo.br/scielo.php?script=sci_arttext&pid=S1516-14392006000300002
Moment of Inertia Calculator | https://skyciv.com/free-moment-of-inertia-calculator/
Material Data | http://www.matweb.com/
Material Data | https://www.matbase.com
Other Resources
Mark McCord L3 Data Package | https://docs.google.com/document/d/1i4anunZXsiG7dyIP78nmFN7WJrSK-7uAgVvensHU9ok/edit#
Static Port Calculator from Off We Go Rocketry Resources | http://www.offwegorocketry.com/pages.php?page=Resources
Fin Flutter Sheet | Ben Murdock
Fin Flutter Calculation | https://www.apogeerockets.com/education/downloads/Newsletter291.pdf
E-Glass Shear Modulus | https://www.azom.com/properties.aspx?ArticleID=764

Sheet: Units and Normalization
Dimensions | Normalization | Mass | Normalization | Force | Normalization | Velocity | Normalization | Acceleration | Normalization | Air Pressure | Normalization
cm | 0.39 | g | 0.001 | kg | 9.81 | fps | 0.30 | f/s² | 0.30 | atm | 14.6959
ft | 12.00 | kg | 1.00 | lb | 4.45 | knot | 0.51 | m/s² | 1.00 | bar | 14.5038
in | 1.00 | lb | 0.45 | N | 1.00 | kph | 0.28 |  |  | mmHg | 0.01933681
m | 39.37 | oz | 0.03 |  |  | m/s | 1.00 |  |  | Pa | 0.000145038
mm | 0.04 |  |  |  |  | mach | 343.00 |  |  | psia | 1.00
 |  |  |  |  |  | mph | 0.45 |  |  | Torr | 0.0193368
