bnparks-KSU/L3CertificationRocket/Solidworks/MotorAssembly.SLDASM

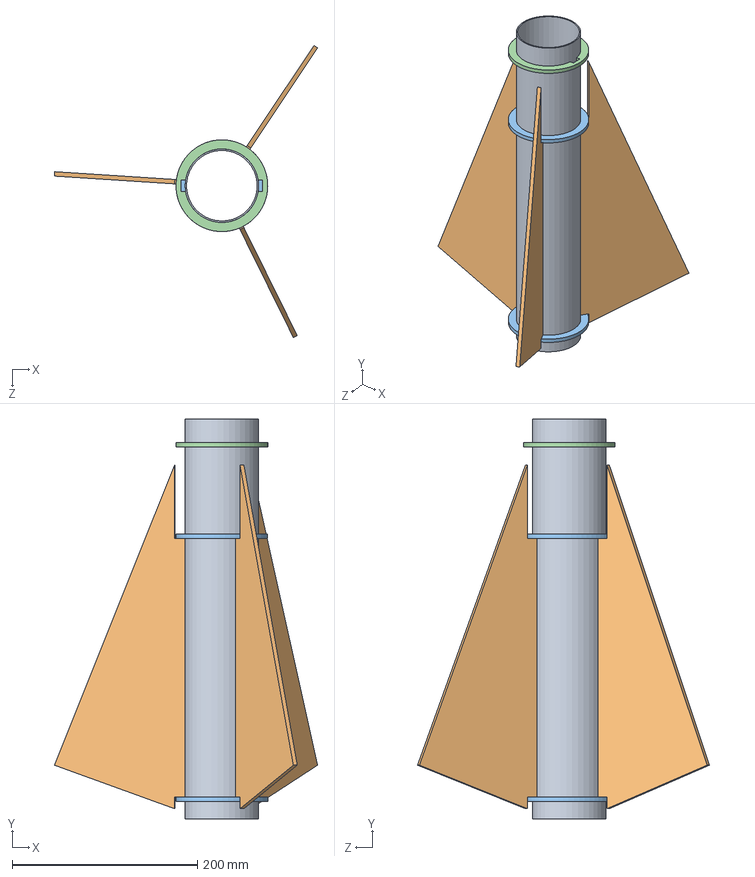
[picture p40: CAD file, 2023-03-11]
Solidworks/MotorAssembly.SLDASM
284.2 x 431.8 x 315.3 mm
MMT
Fin x 3
CenteringRing x 2
CenteringRingCut
