bnparks-KSU/L3CertificationRocket/Solidworks/EBayBulkheadAssembly.SLDASM

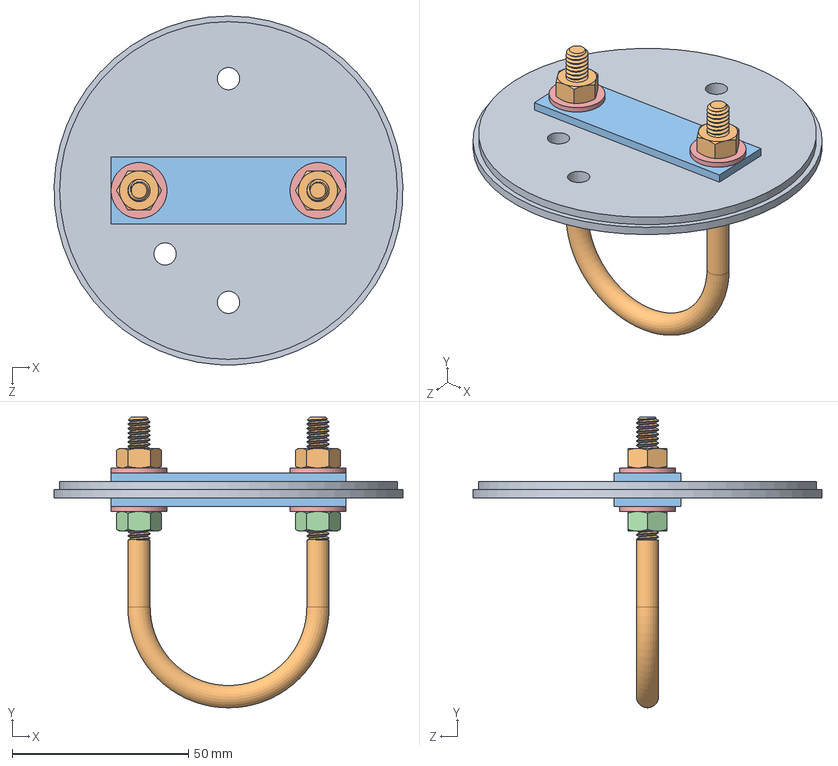
[picture p41: CAD file, 2023-02-02]
Solidworks/EBayBulkheadAssembly.SLDASM
99.1 x 82.6 x 99.1 mm
EBayBulkhead
3043T618_U-Bolt
8875T929_Mount Plate for 1 4 -20 Thread x 2
91845A029_18-8 Stainless Steel Hex Nut x 2
92141A029_18-8 Stainless Steel Washer x 4
