bnparks-KSU/L3CertificationRocket/Solidworks/6FtMainChute.SLDPRT

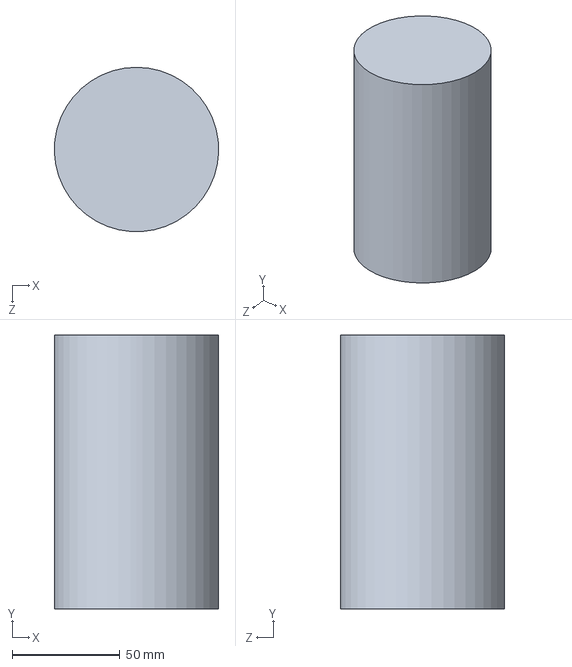
[picture p42: CAD file, 2023-01-31]
Solidworks/6FtMainChute.SLDPRT
76.1 x 127.0 x 76.2 mm
