bnparks-KSU/L3CertificationRocket/Manufacturing/3DPrinting/STLs/AftCenteringRingSpacer.STL

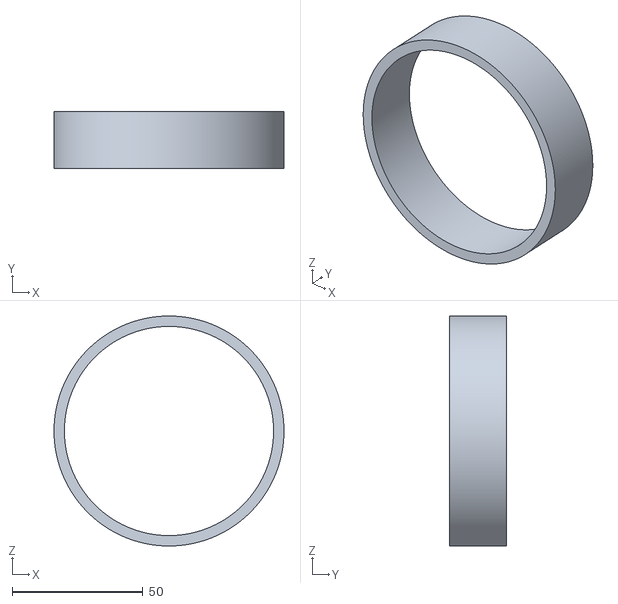
[picture p43: CAD file, 2023-03-11]
Manufacturing/3DPrinting/STLs/AftCenteringRingSpacer.STL
88.0 x 22.0 x 88.0
