bnparks-KSU/L3CertificationRocket/Solidworks/EBaySled.SLDPRT

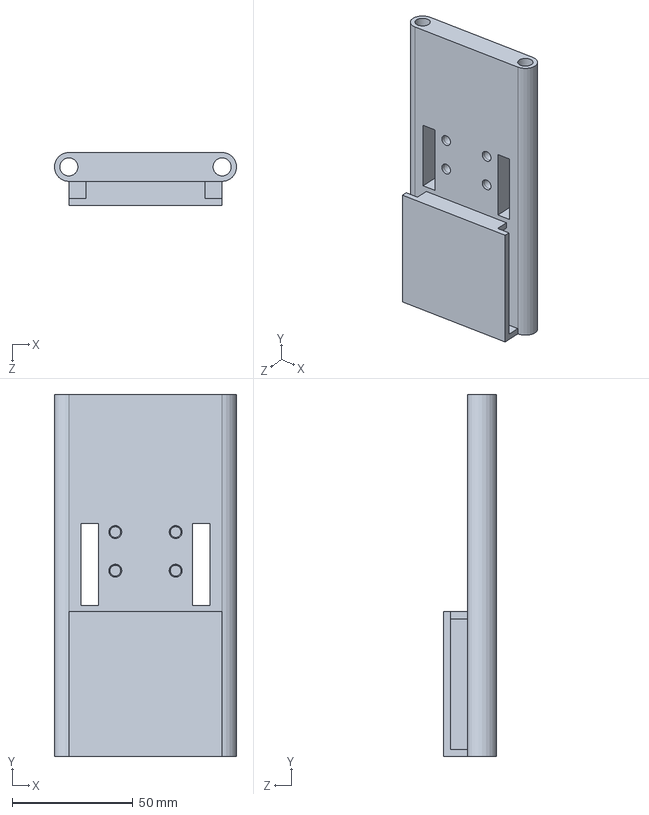
[picture p44: CAD file, 2023-03-11]
Solidworks/EBaySled.SLDPRT
75.5 x 150.0 x 22.0 mm
