bnparks-KSU/L3CertificationRocket/Solidworks/Jigs/4HoleJig.SLDPRT

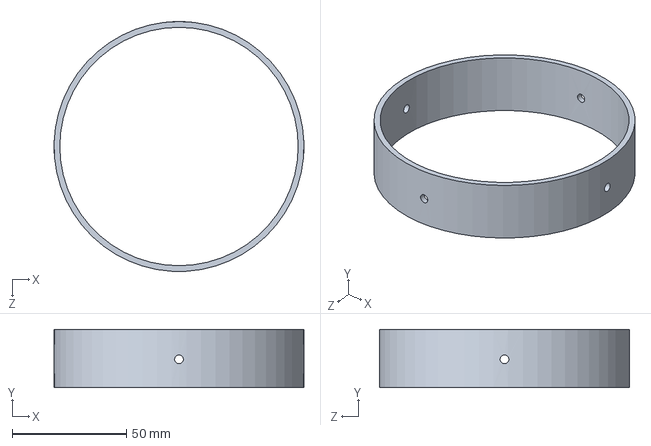
[picture p45: CAD file, 2023-03-11]
Solidworks/Jigs/4HoleJig.SLDPRT
109.2 x 25.4 x 109.2 mm
