bnparks-KSU/L3CertificationRocket/Solidworks/OtherCommercial/TeleMega.SLDPRT

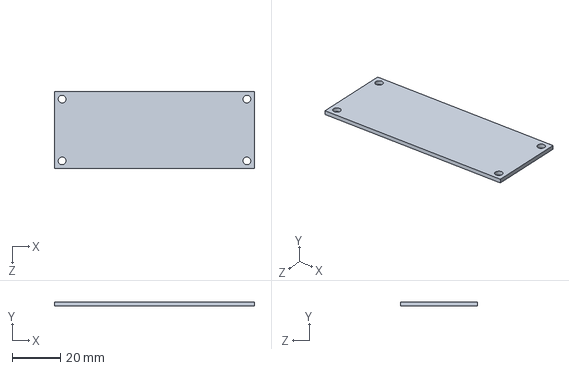
[picture p46: CAD file, 2023-03-11]
Solidworks/OtherCommercial/TeleMega.SLDPRT
82.5 x 1.60 x 31.8 mm
