bnparks-KSU/L3CertificationRocket/Manufacturing/3DPrinting/STLs/Camera Shroud Base Rev2.STL

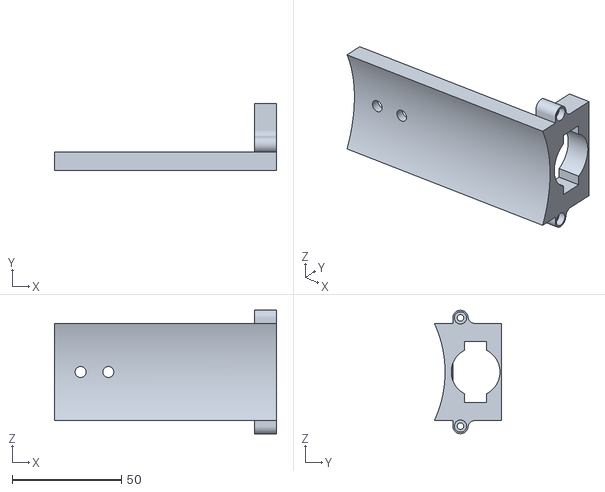
[picture p47: CAD file, 2023-03-11]
Manufacturing/3DPrinting/STLs/Camera Shroud Base Rev2.STL
101.6 x 30.8 x 56.5
