bnparks-KSU/L3CertificationRocket/Solidworks/Jigs/FinPositionJigTop.SLDPRT

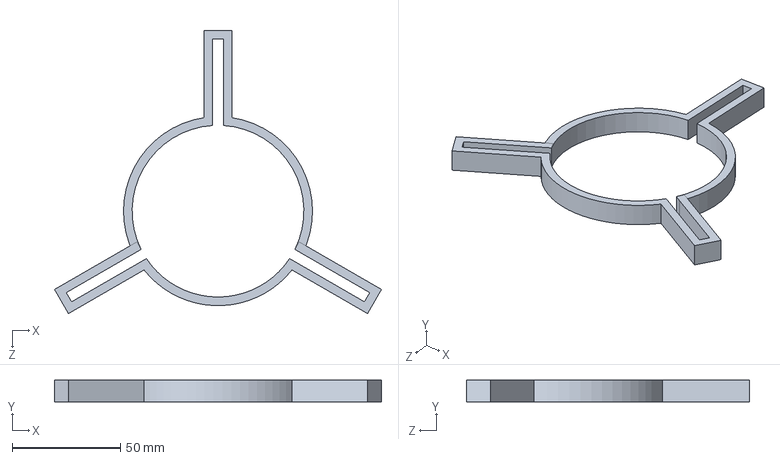
[picture p48: CAD file, 2023-03-11]
Solidworks/Jigs/FinPositionJigTop.SLDPRT
151.4 x 10.0 x 131.1 mm
