bnparks-KSU/L3CertificationRocket/Solidworks/OtherCommercial/Camera Shroud Cover Rev2.sldprt

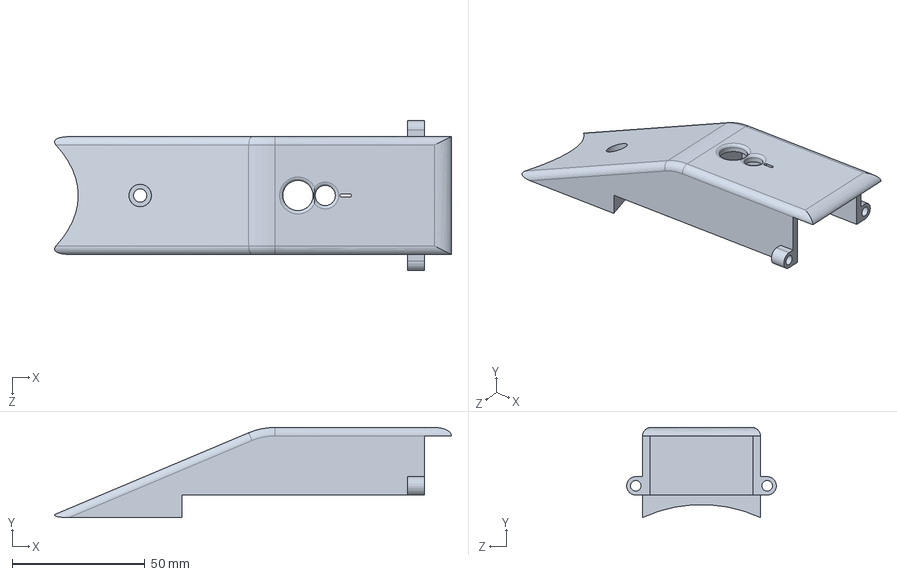
[picture p49: CAD file, 2023-03-11]
Solidworks/OtherCommercial/Camera Shroud Cover Rev2.sldprt
149.7 x 34.0 x 56.5 mm
