bnparks-KSU/L3CertificationRocket/Solidworks/CouplerBulkheadAft.SLDPRT

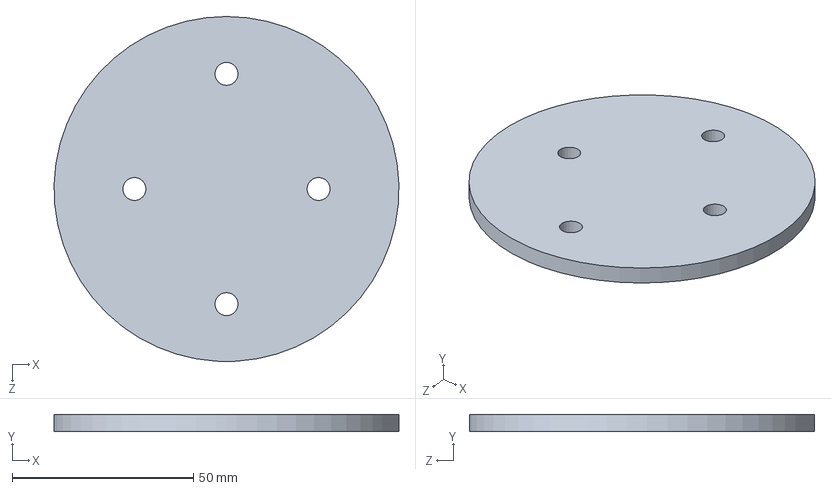
[picture p50: CAD file, 2023-02-02]
Solidworks/CouplerBulkheadAft.SLDPRT
95.1 x 4.76 x 95.2 mm
