bnparks-KSU/L3CertificationRocket/Solidworks/EBayBulkhead.SLDPRT

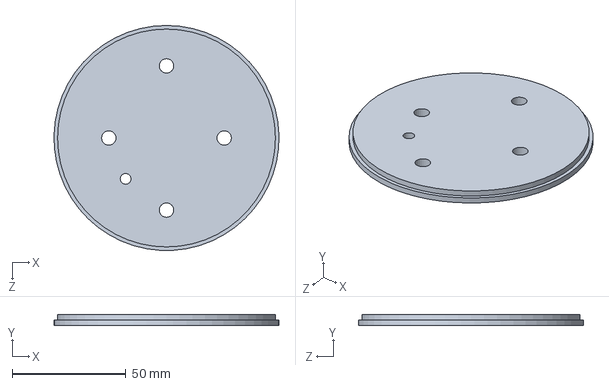
[picture p51: CAD file, 2023-02-02]
Solidworks/EBayBulkhead.SLDPRT
99.1 x 4.72 x 99.1 mm
