bnparks-KSU/L3CertificationRocket/Manufacturing/3DPrinting/STLs/FinPositionJig.STL

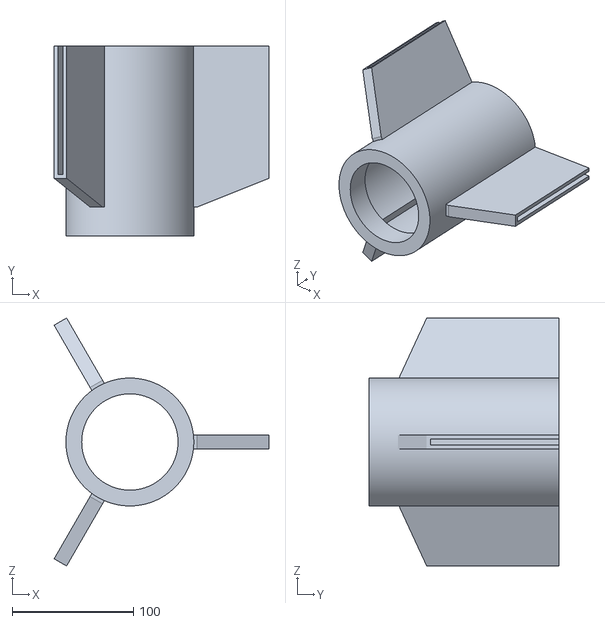
[picture p52: CAD file, 2023-03-11]
Manufacturing/3DPrinting/STLs/FinPositionJig.STL
177.2 x 157.0 x 204.6
