bnparks-KSU/L3CertificationRocket/Solidworks/CenteringRing.SLDPRT

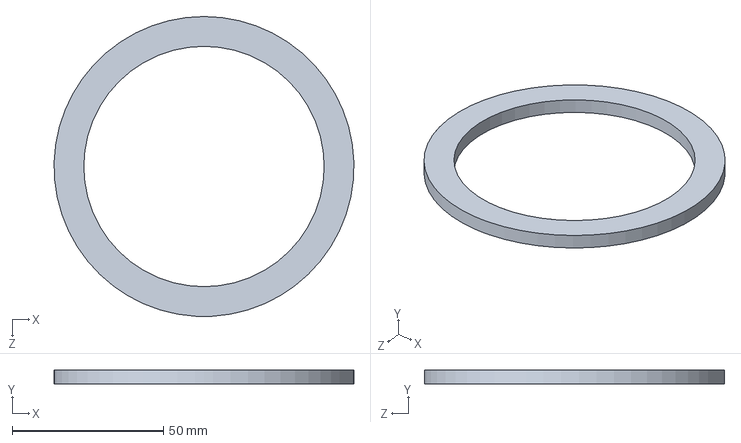
[picture p53: CAD file, 2023-02-01]
Solidworks/CenteringRing.SLDPRT
99.1 x 4.76 x 99.1 mm
