bnparks-KSU/L3CertificationRocket/Solidworks/Jigs/EBayHoleJig.SLDPRT

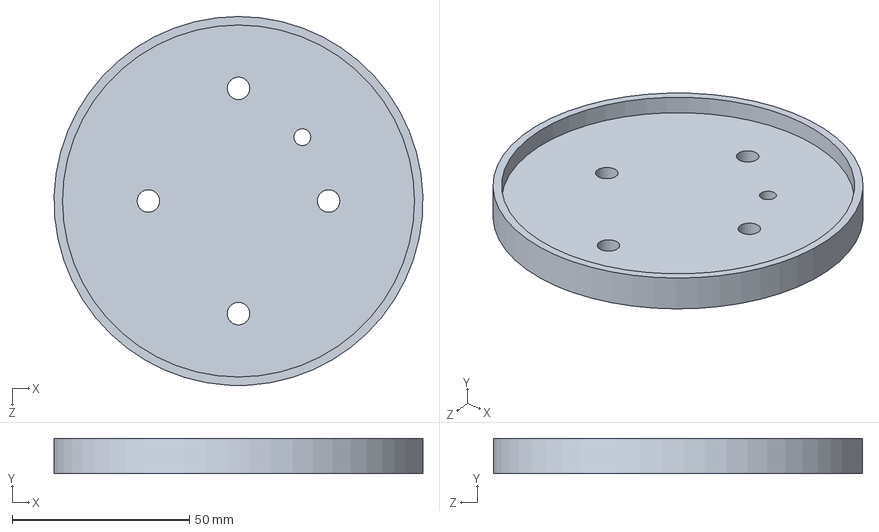
[picture p54: CAD file, 2023-02-02]
Solidworks/Jigs/EBayHoleJig.SLDPRT
104.0 x 10.0 x 104.0 mm
