bnparks-KSU/L3CertificationRocket/Solidworks/OtherCommercial/EasyMini.SLDPRT

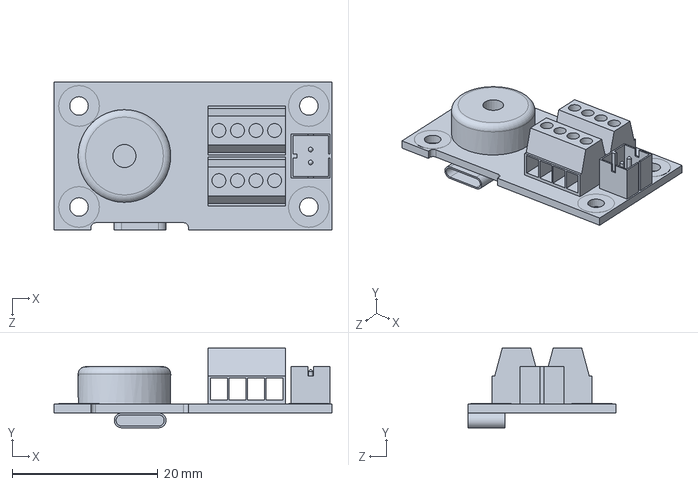
[picture p55: CAD file, 2023-03-11]
Solidworks/OtherCommercial/EasyMini.SLDPRT
38.1 x 10.9 x 20.3 mm
