bnparks-KSU/L3CertificationRocket/Solidworks/CenteringRingCut.SLDPRT

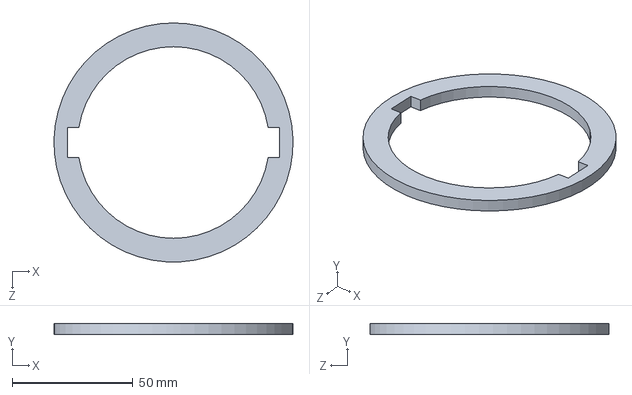
[picture p56: CAD file, 2023-02-01]
Solidworks/CenteringRingCut.SLDPRT
99.1 x 4.76 x 99.1 mm
