bnparks-KSU/L3CertificationRocket/Solidworks/NoseCone.SLDPRT

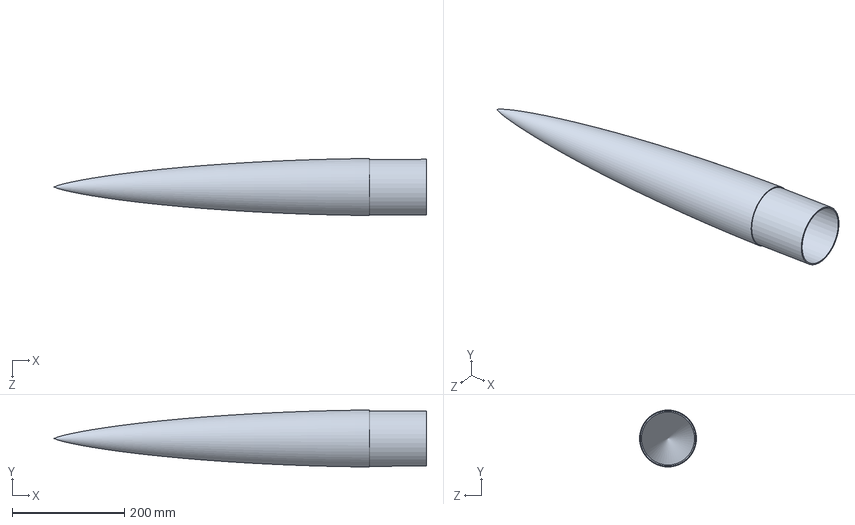
[picture p57: CAD file, 2023-01-31]
Solidworks/NoseCone.SLDPRT
664.0 x 101.6 x 101.6 mm
