bnparks-KSU/L3CertificationRocket/Solidworks/Fin.SLDPRT

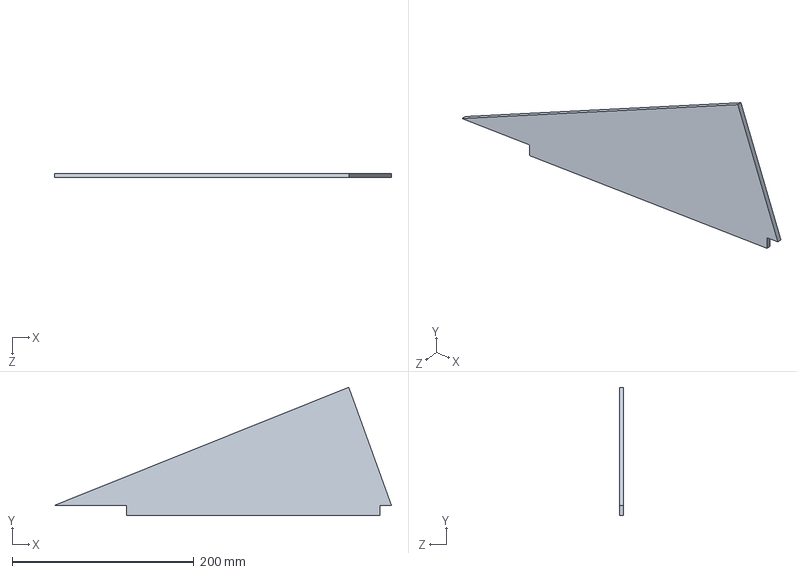
[picture p58: CAD file, 2023-01-31]
Solidworks/Fin.SLDPRT
371.0 x 141.4 x 4.76 mm
