bnparks-KSU/L3CertificationRocket/Solidworks/UpperBodyTube.SLDPRT

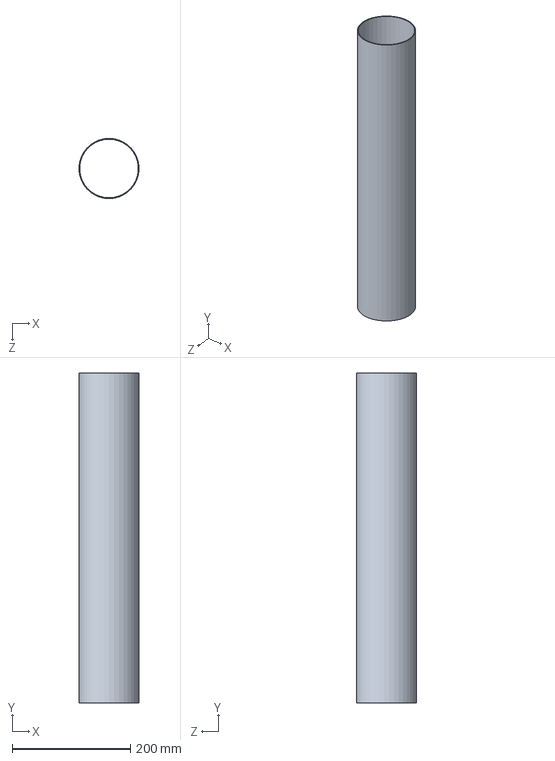
[picture p59: CAD file, 2023-01-31]
Solidworks/UpperBodyTube.SLDPRT
101.7 x 558.8 x 102.0 mm
