bnparks-KSU/L3CertificationRocket/Solidworks/MMT.SLDPRT

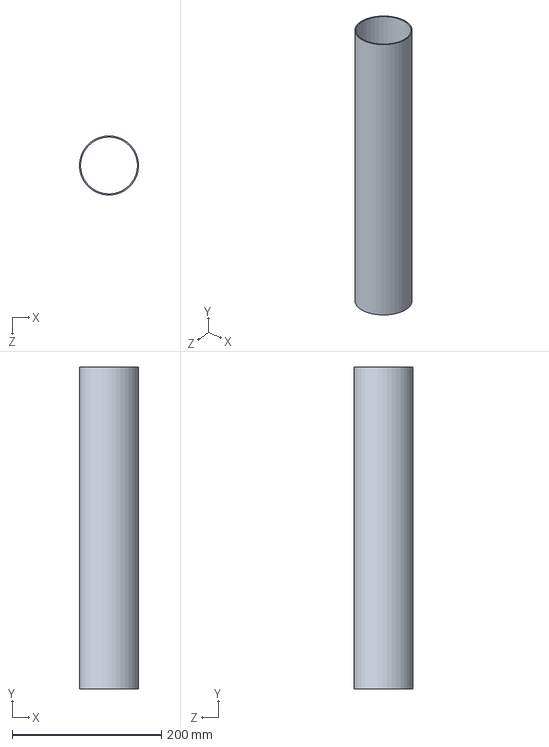
[picture p60: CAD file, 2023-01-31]
Solidworks/MMT.SLDPRT
79.3 x 431.8 x 79.4 mm
