bnparks-KSU/L3CertificationRocket/Solidworks/EBayCoupler.SLDPRT

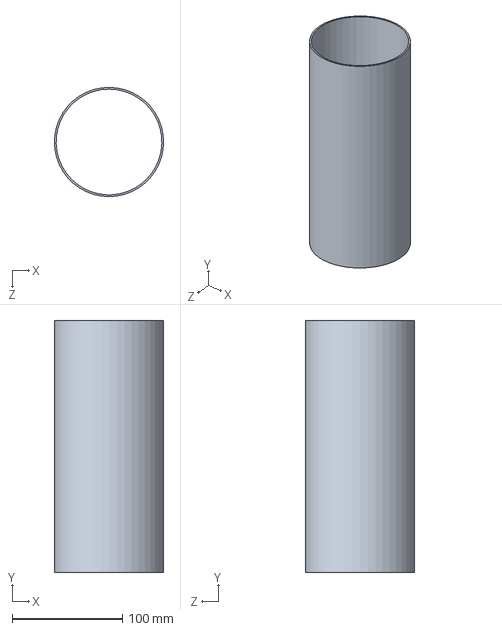
[picture p61: CAD file, 2023-01-31]
Solidworks/EBayCoupler.SLDPRT
99.1 x 228.6 x 99.1 mm
