bnparks-KSU/L3CertificationRocket/Solidworks/SwitchBand.SLDPRT

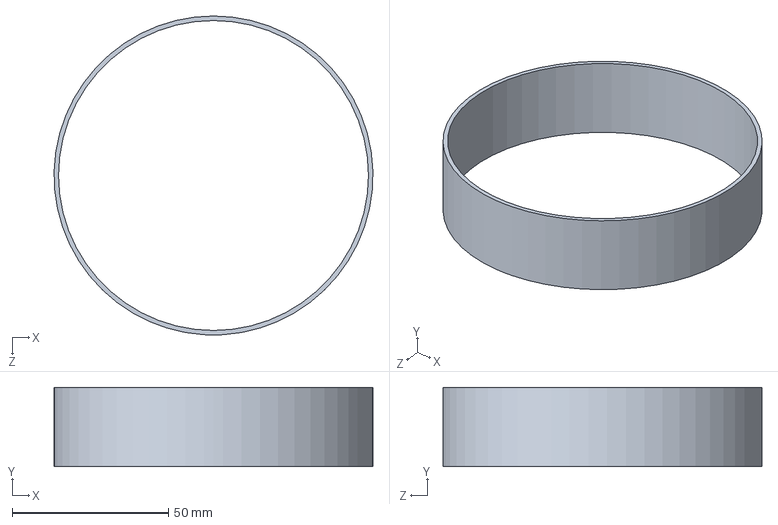
[picture p62: CAD file, 2023-01-31]
Solidworks/SwitchBand.SLDPRT
102.0 x 25.4 x 102.0 mm
