bnparks-KSU/L3CertificationRocket/Solidworks/2FtDrogueChute.SLDPRT

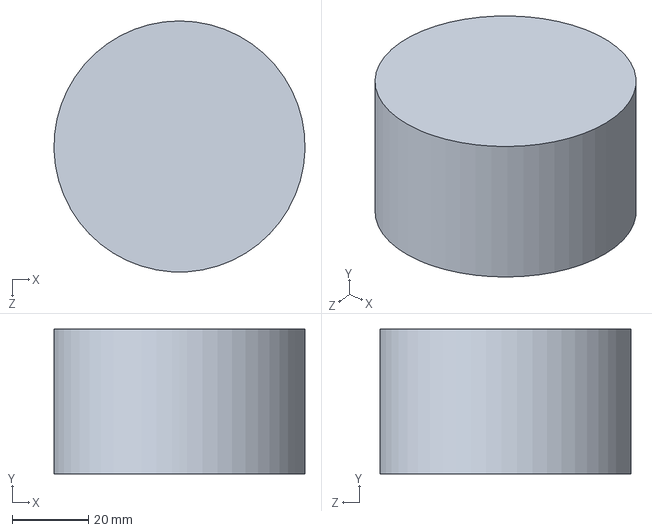
[picture p63: CAD file, 2023-01-31]
Solidworks/2FtDrogueChute.SLDPRT
66.0 x 38.1 x 66.0 mm
