bnparks-KSU/L3CertificationRocket/Solidworks/LowerBodyTube.SLDPRT

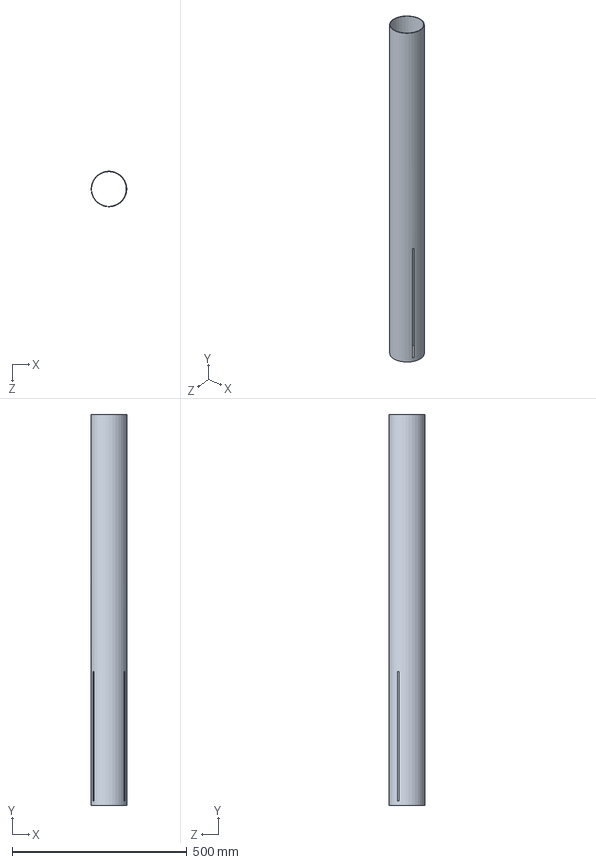
[picture p64: CAD file, 2023-01-31]
Solidworks/LowerBodyTube.SLDPRT
101.6 x 1117.6 x 102.0 mm
