bnparks-KSU/L3CertificationRocket/Solidworks/75-5120 Casing.SLDPRT

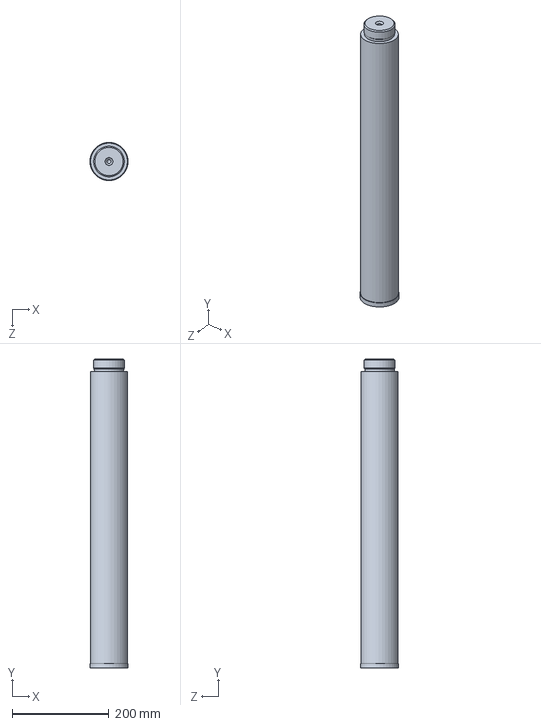
[picture p65: CAD file, 2023-01-31]
Solidworks/75-5120 Casing.SLDPRT
78.7 x 638.2 x 78.7 mm
