bnparks-KSU/L3CertificationRocket/(list of files, cad)

Other CAD files:
Solidworks/Jigs/2HoleJig.SLDPRT
Manufacturing/3DPrinting/STLs/2HoleJig.STL
Manufacturing/3DPrinting/STLs/3HoleJig.STL
Solidworks/Jigs/3HoleJig.SLDPRT
Solidworks/OtherCommercial/Camera Shroud Base Rev2.SLDPRT
Manufacturing/3DPrinting/STLs/FinPositionJigTop.STL
Solidworks/Jigs/AftCenteringRingSpacer.SLDPRT
Solidworks/Jigs/FinPositionJig.SLDPRT
Manufacturing/3DPrinting/STLs/EBaySled.STL
Solidworks/CouplerBulkheadForward.SLDPRT
Manufacturing/3DPrinting/STLs/4HoleJig.STL
Manufacturing/3DPrinting/STLs/EBayHoleJig.STL
Solidworks/McMaster/3043T618_U-Bolt.SLDPRT
Solidworks/McMaster/8875T929_Mount Plate for 1 4 -20 Thread.SLDPRT
Solidworks/McMaster/91845A029_18-8 Stainless Steel Hex Nut.SLDPRT
Solidworks/McMaster/92141A029_18-8 Stainless Steel Washer.SLDPRT
Solidworks/McMaster/M3HeatInsert_94180A331.SLDPRT
Solidworks/OtherCommercial/M3X6Screw.step
Solidworks/OtherCommercial/M3x6Standoff.step
Solidworks/OtherCommercial/ScrewSwitch.SLDPRT
