bnparks-KSU/L3CertificationRocket/Documentation/Photos/Physical/AssembledBulkheads.jpg

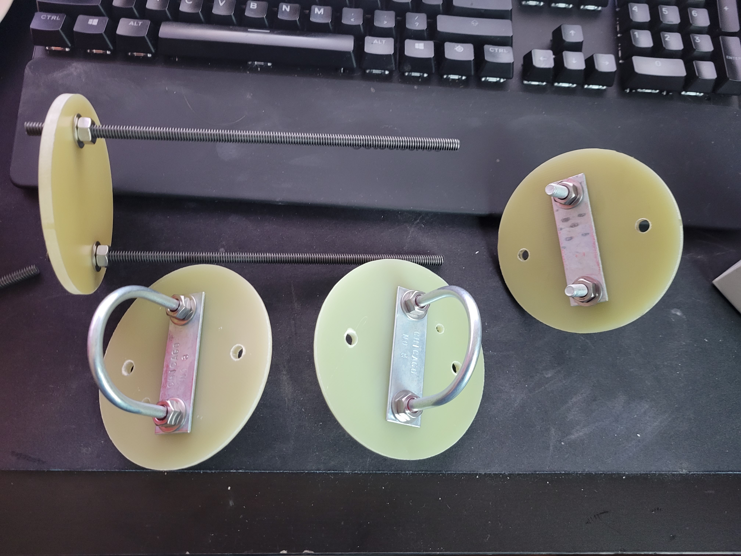
Documentation/Photos/Physical/AssembledBulkheads.jpg
