bnparks-KSU/L3CertificationRocket/Documentation/Photos/Physical/InsertedRailGuide.jpg

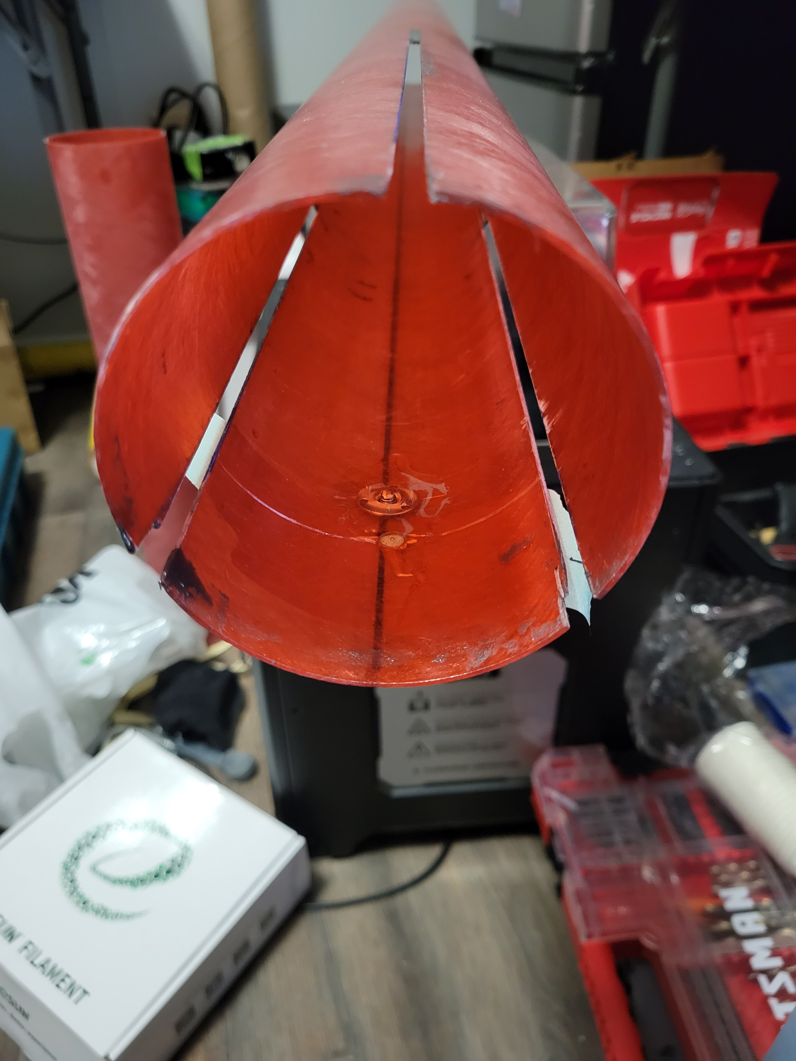
Documentation/Photos/Physical/InsertedRailGuide.jpg
