bnparks-KSU/L3CertificationRocket/Documentation/Photos/Solidworks/WiringDiagrams.PNG

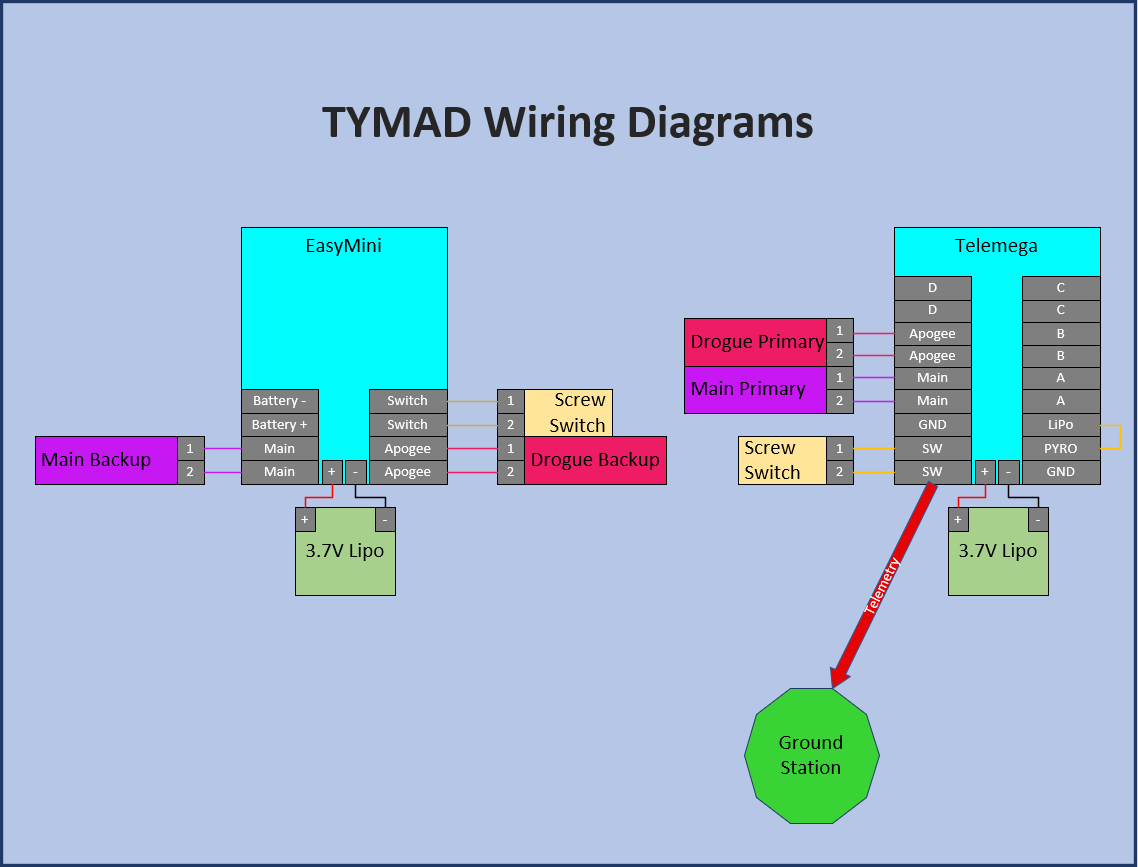
Documentation/Photos/Solidworks/WiringDiagrams.PNG
