bnparks-KSU/L3CertificationRocket/(commit log)

2022-12-30 Current status
    [L3DCC.xlsx]
2023-01-28 Laptop push
    [CenteringRing.SLDPRT, Fin.SLDPRT, LowerBodyTube.SLDPRT, MMT.SLDPRT, MotorAssembly.SLDASM]
2023-01-31 Updates for arrival
    [2FtDrogueChute.SLDPRT, 3043T618_U-Bolt.SLDPRT, 6FtMainChute.SLDPRT, 75-5120 Casing.SLDPRT, 8875T929_Mount Plate for 1 4 -20 Thread.SLDPRT, 91845A029_18-8 Stainless Steel Hex Nut.SLDPRT, 92141A029_18-8 Stainless Steel Washer.SLDPRT, CenteringRing.SLDPRT]
2023-02-01 CNC Files
    [CenteringRing.SLDPRT, CenteringRingCut.SLDPRT, CouplerBulkheadAft.SLDPRT, CouplerBulkheadForward.SLDPRT]
2023-03-11 Big update
    [2HoleJig.SLDPRT, 2HoleJig.STL, 3HoleJig.SLDPRT, 3HoleJig.STL, 4HoleJig.SLDPRT, 4HoleJig.STL, AftCenteringRingSpacer.SLDPRT, AftCenteringRingSpacer.STL]
