bnparks-KSU/L3CertificationRocket/Documentation/Photos/Physical/5MinuteTacking.jpg

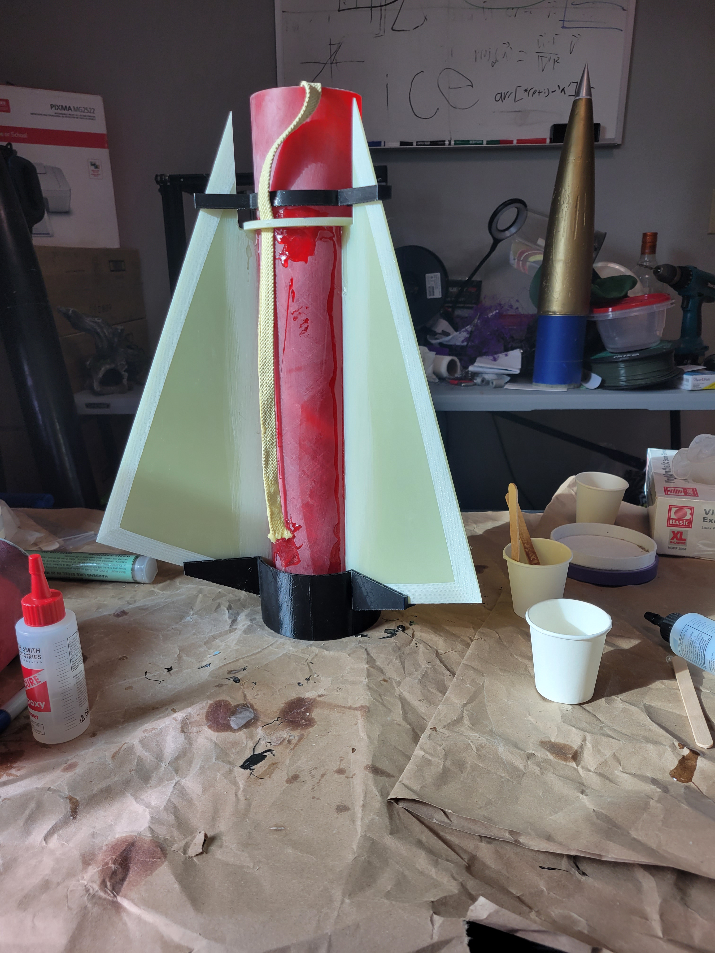
Documentation/Photos/Physical/5MinuteTacking.jpg
