bnparks-KSU/L3CertificationRocket/Documentation/Photos/Physical/NoseconeCoupler-Epoxy2.jpg

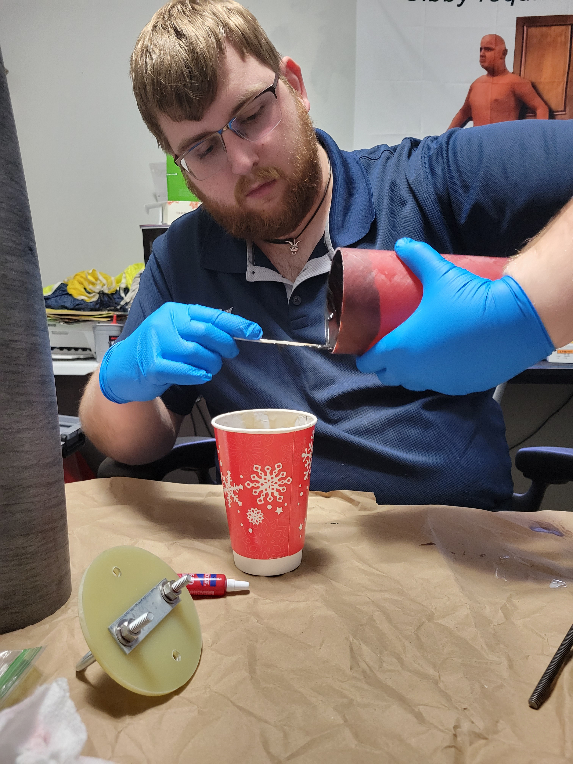
Documentation/Photos/Physical/NoseconeCoupler-Epoxy2.jpg
